CV19CO/open_controller_for_ventilator/README.md

# Open source controller board for ventilators 

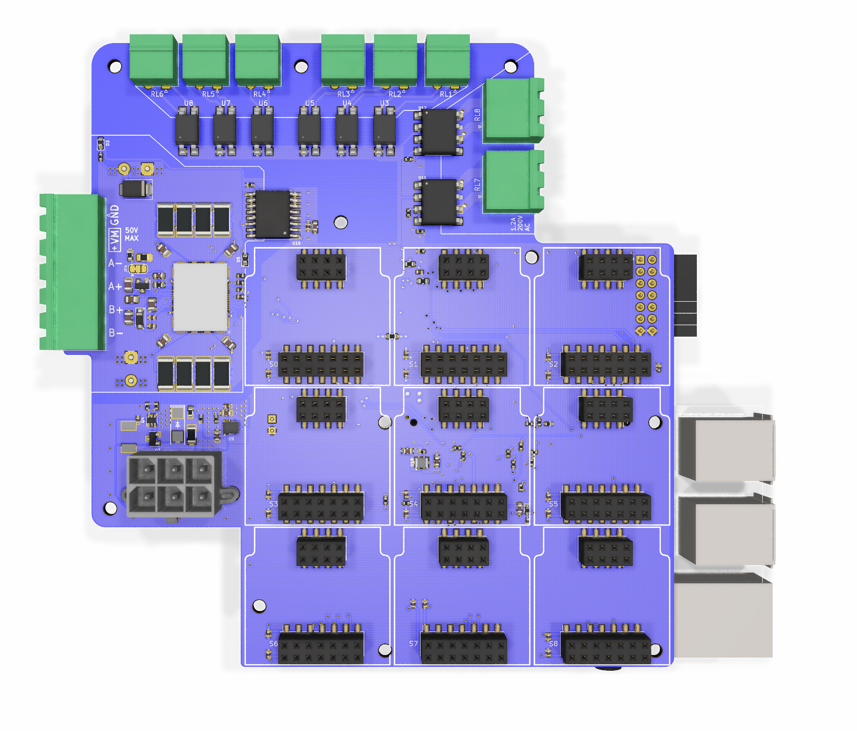
[picture p1: doc/top.png]
Top view


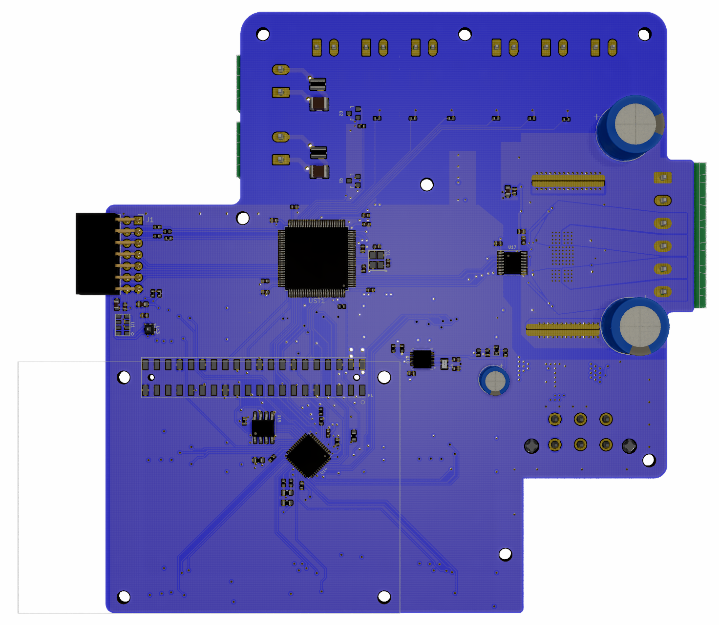
[picture p2: doc/bot.png]
Bottom view
