CV19CO/open_controller_for_ventilator/stm32f4_modules/readme.txt

Toolchain for stm32f4 programming:

> sudo apt-get install build-essential 
> sudo apt-get install git binutils-arm-none-eabi
> sudo apt-get install gcc-arm-none-eabi
> sudo apt-get install libnewlib-arm-none-eabi
