CV19CO/open_controller_for_ventilator/ABPDJJT001PGAA5_sensor/readme.txt

Sensor: ABPDANT015PGAA5 
Mouser: https://co.mouser.com/ProductDetail/785-ABPDANT015PGAA5
Datasheet: https://co.mouser.com/datasheet/2/187/honeywell-sensing-basic-board-mount-pressure-abp-s-1662208.pdf
