CV19CO/open_controller_for_ventilator/ABPDJJT001PDSA3_sensor/readme.txt

Sensor: ABPDJJT001PDSA3 
Mouser: https://co.mouser.com/ProductDetail/785-ABPDJJT001PDSA3
Datasheet: https://co.mouser.com/datasheet/2/187/honeywell-sensing-basic-board-mount-pressure-abp-s-1662208.pdf
