CV19CO/open_controller_for_ventilator/pressure_sensor_module/readme.txt

Sensor: MPX5100AP 
Mouser: https://co.mouser.com/ProductDetail/841-MPX5100AP
Datasheet: https://co.mouser.com/datasheet/2/302/MPX5100-1127023.pdf
