CV19CO/open_controller_for_ventilator/stm32f4_modules/modules/clk_ice40/leeme.txt

20200407
En esta versión se modificó la forma de enviar los datos 
colocando una única cadena con la información de los 16 canales
