CV19CO/open_controller_for_ventilator/sensor_oxigeno/BOM_sensor_oxigeno.csv

Item | Qty | Reference(s) | Value | Footprint
1 | 1 | J1 | Conn_01x02_Female | Connector:FanPinHeader_1x03_P2.54mm_Vertical
2 | 1 | J2 | Conn_02x07_Odd_Even | Connector_PinHeader_2.54mm:PinHeader_2x07_P2.54mm_Vertical
3 | 1 | J3 | Conn_02x04_Odd_Even | Connector_PinHeader_2.54mm:PinHeader_2x04_P2.54mm_Vertical
4 | 1 | R1 | 25.3 k | Resistor_THT:R_Axial_DIN0207_L6.3mm_D2.5mm_P7.62mm_Horizontal
5 | 1 | R2 | 100 | Resistor_THT:R_Axial_DIN0207_L6.3mm_D2.5mm_P7.62mm_Horizontal
6 | 4 | R3, R4, R5, R6 | 10k | Resistor_THT:R_Axial_DIN0207_L6.3mm_D2.5mm_P7.62mm_Horizontal
7 | 1 | R7 | 50 | Resistor_THT:R_Axial_DIN0207_L6.3mm_D2.5mm_P7.62mm_Horizontal
8 | 1 | U1 | LM318N | Package_DIP:DIP-8_W7.62mm
9 | 1 | U2 | INA128 | Package_DIP:DIP-8_W7.62mm
