CV19CO/open_controller_for_ventilator/ABPDJJT001PDSA3_sensor/BOM_ABPDJJT001PDSA3_sensor_module.csv

Reference | Quantity | Value | Footprint | Datasheet | DigiKey
C1 | 1 | 0.1u | Capacitor_SMD:C_0603_1608Metric | ~ | 1276-1258-1-ND
J1 | 1 | Conn_02x04_Odd_Even | Connector_PinHeader_2.54mm:PinHeader_2x04_P2.54mm_Vertical_SMD | ~ | 609-6367-ND
J2 | 1 | Conn_02x07_Odd_Even | Connector_PinHeader_2.54mm:PinHeader_2x07_P2.54mm_Vertical_SMD | ~ | 609-6365-ND
U1 | 1 | ABPDJJ001PDSA3 | TH_project:DIP_JJ
