CV19CO/open_controller_for_ventilator/pressure_sensor_module/BOM_pressure_sensor_module.csv

Reference | Quantity | Value | Footprint | Datasheet | DigiKey
C1 | 1 | 1u | Capacitor_SMD:C_0603_1608Metric | ~ | 1276-1182-1-ND
C2 | 1 | 470p | Capacitor_SMD:C_0603_1608Metric | ~ | 1276-1168-1-ND
C3 C4 | 2 | 0.1u | Capacitor_SMD:C_0603_1608Metric | ~ | 1276-1258-1-ND
J1 | 1 | Conn_02x04_Odd_Even | Connector_PinHeader_2.54mm:PinHeader_2x04_P2.54mm_Vertical_SMD | ~ | 609-6367-ND
J2 | 1 | Conn_02x07_Odd_Even | Connector_PinHeader_2.54mm:PinHeader_2x07_P2.54mm_Vertical_SMD | ~ | 609-6365-ND
R1 | 1 | 11k3 | Resistor_SMD:R_0603_1608Metric | ~ | A102208CT-ND
R2 | 1 | 22k | Resistor_SMD:R_0603_1608Metric | ~ | A103066CT-ND
U1 | 1 | MPX5100AP | TH_project:MPX5100
U2 | 1 | LM358 | Package_SO:TSSOP-8_4.4x3mm_P0.65mm | http://www.ti.com/lit/ds/symlink/lm2904-n.pdf | 296-51268-1-ND
