CV19CO/open_controller_for_ventilator/kicad-modules/shapes3d/User Library-bornera-1.STEP

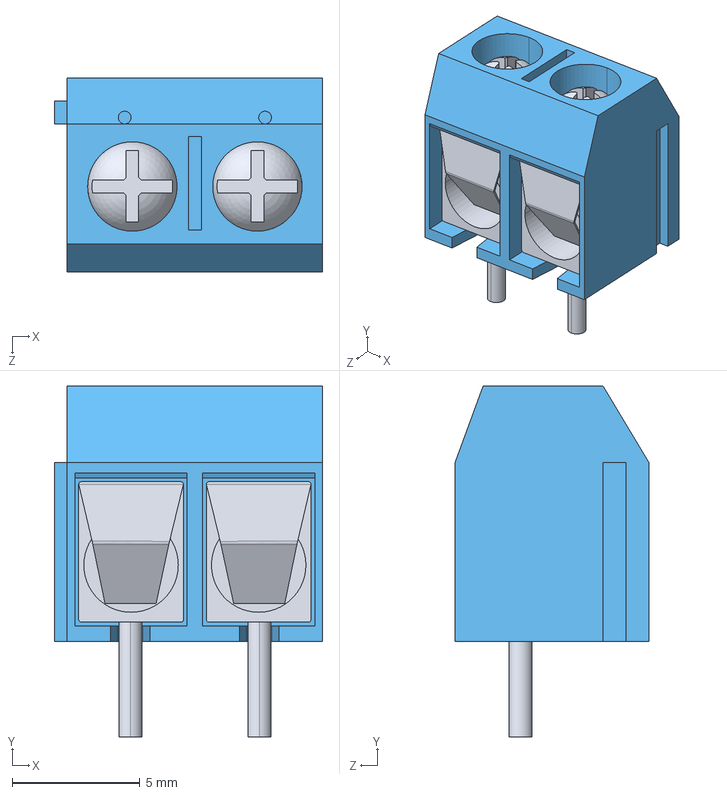
[picture p3: CAD file, 2023-04-05]
kicad-modules/shapes3d/User Library-bornera-1.STEP
10.5 x 13.8 x 7.60 mm
