CV19CO/open_controller_for_ventilator/pressure_sensor_module/pressure_sensor_module.step

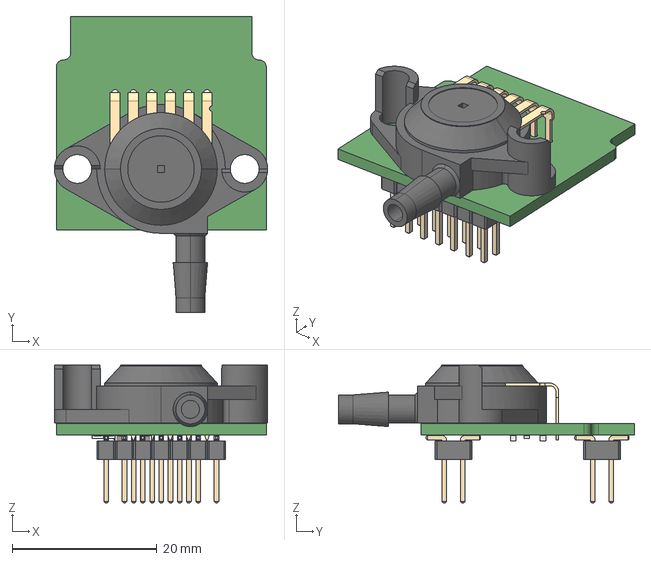
[picture p4: CAD file, 2020-06-25]
pressure_sensor_module/pressure_sensor_module.step
29.5 x 40.9 x 19.0 mm
