CV19CO/open_controller_for_ventilator/kicad-modules/shapes3d/abpdjjt001pgaa5.stp

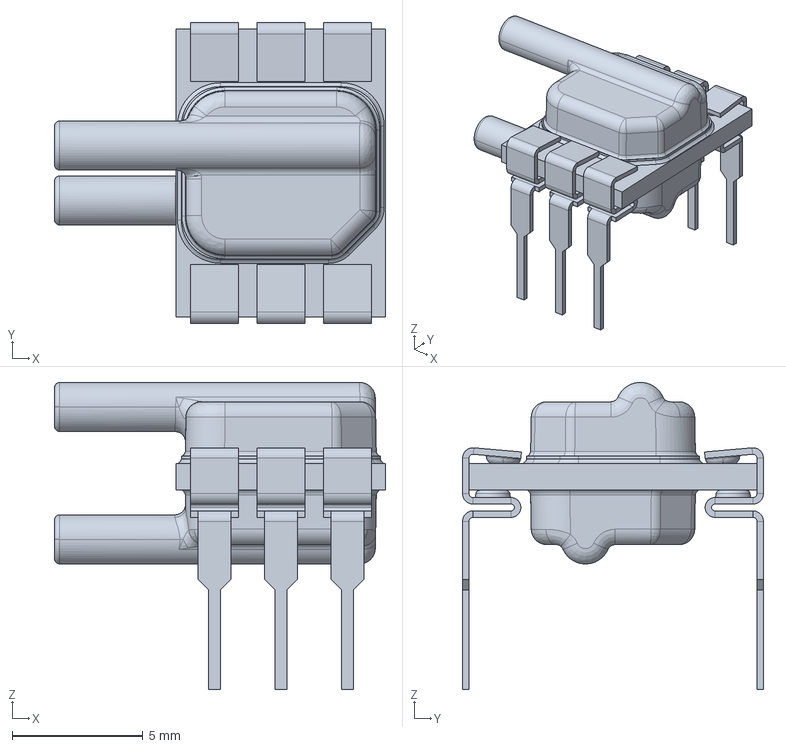
[picture p5: CAD file, 2022-02-02]
kicad-modules/shapes3d/abpdjjt001pgaa5.stp
12.7 x 11.5 x 11.7 mm
