CV19CO/open_controller_for_ventilator/kicad-modules/shapes3d/abpdant005pgaa5.stp

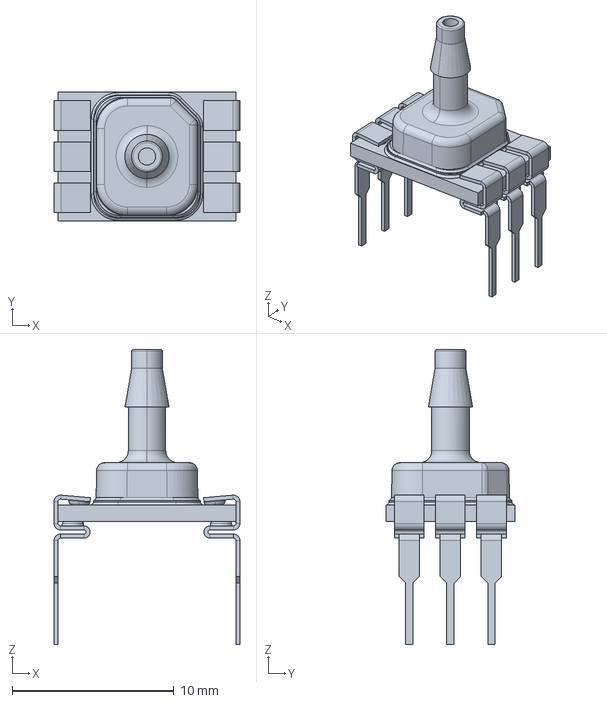
[picture p6: CAD file, 2022-02-02]
kicad-modules/shapes3d/abpdant005pgaa5.stp
11.5 x 8.00 x 18.2 mm
