CV19CO/open_controller_for_ventilator/kicad-modules/shapes3d/ABPDJJT001PDSA3.stp

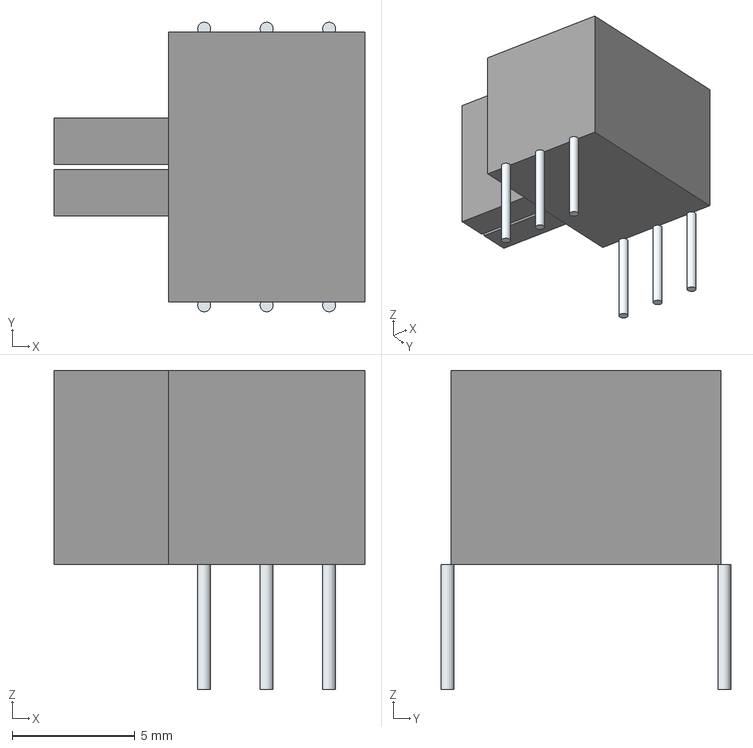
[picture p7: CAD file, 2020-07-11]
kicad-modules/shapes3d/ABPDJJT001PDSA3.stp
12.6 x 11.8 x 13.0 mm
Leads
