CV19CO/open_controller_for_ventilator/kicad-modules/shapes3d/MPX5100GP.step

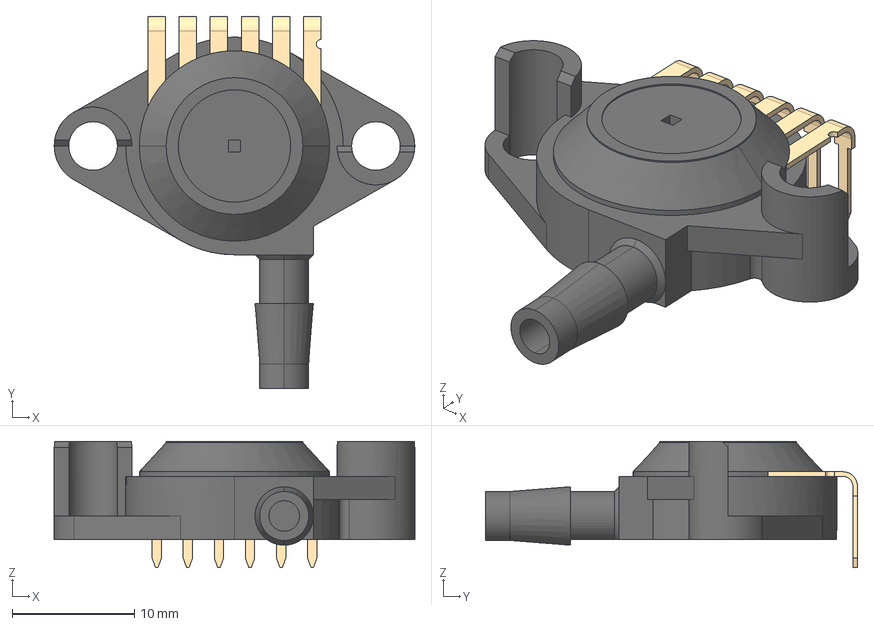
[picture p8: CAD file, 2020-06-25]
kicad-modules/shapes3d/MPX5100GP.step
29.5 x 30.4 x 10.3 mm
