CV19CO/open_controller_for_ventilator/kicad-modules/shapes3d/S-Mini-ZKN.STEP

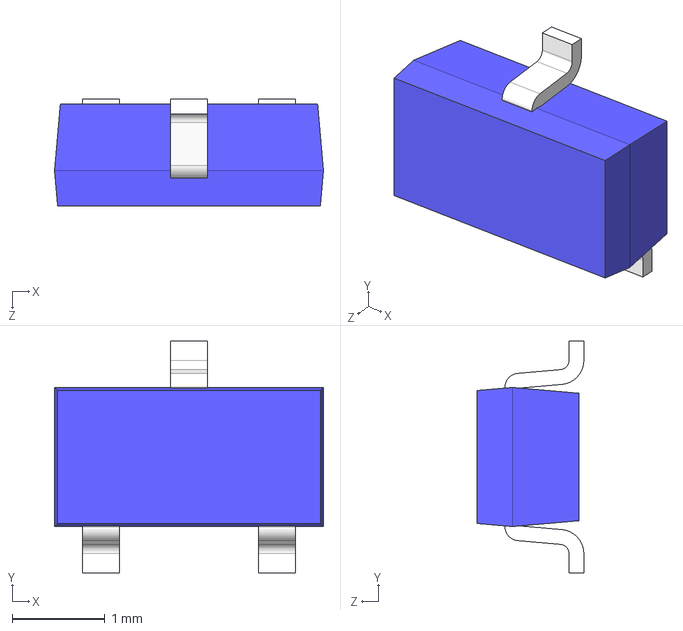
[picture p9: CAD file, 2020-05-23]
kicad-modules/shapes3d/S-Mini-ZKN.STEP
2.90 x 2.50 x 1.15 mm
