CV19CO/open_controller_for_ventilator/kicad-modules/shapes3d/CUI_DEVICES_CSS-95B30-SMT-TR.step

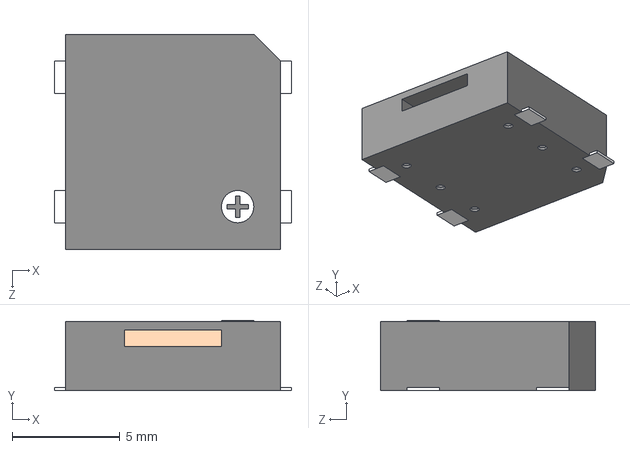
[picture p10: CAD file, 2020-05-11]
kicad-modules/shapes3d/CUI_DEVICES_CSS-95B30-SMT-TR.step
11.0 x 3.25 x 10.0 mm
