CV19CO/open_controller_for_ventilator/kicad-modules/shapes3d/pxc_1757284_06_MSTBA-2-5-6-G-5-08_3D.stp

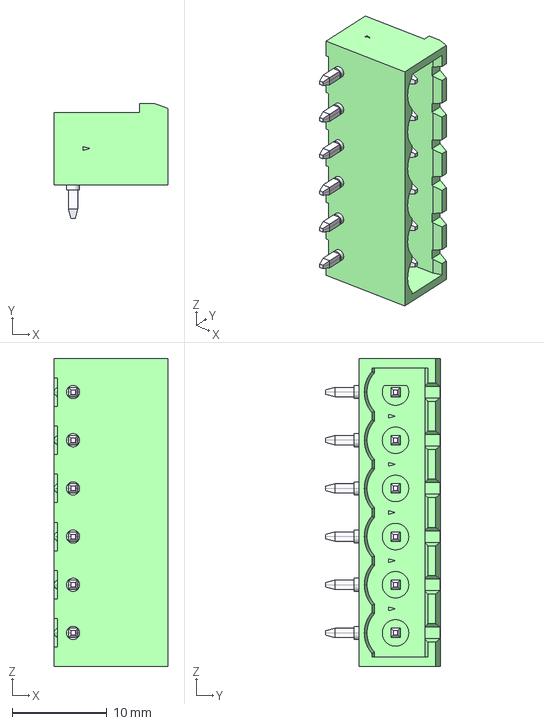
[picture p11: CAD file, 2020-05-11]
kicad-modules/shapes3d/pxc_1757284_06_MSTBA-2-5-6-G-5-08_3D.stp
12.0 x 12.1 x 32.5 mm
