CV19CO/open_controller_for_ventilator/kicad-modules/shapes3d/CUI_DEVICES_CEP-1112.step

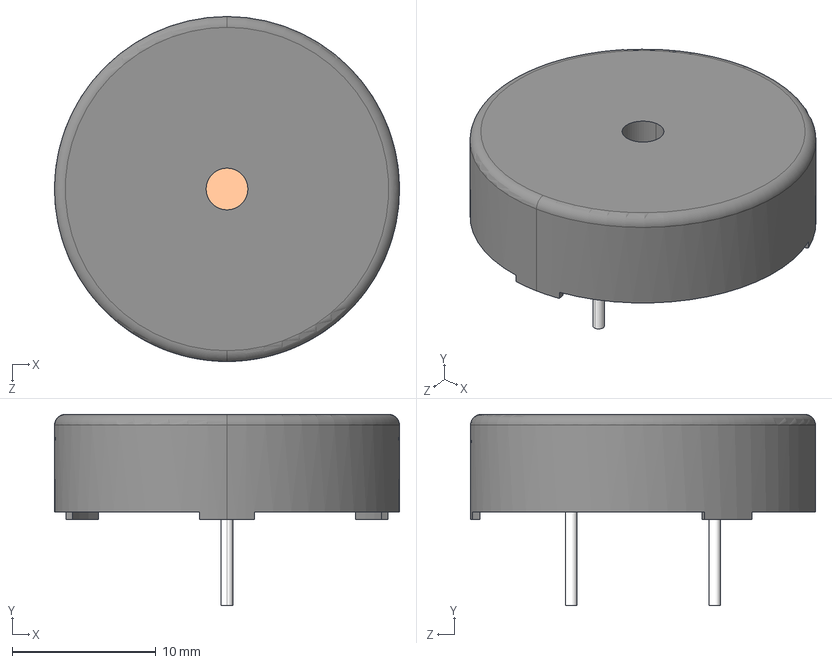
[picture p12: CAD file, 2020-05-11]
kicad-modules/shapes3d/CUI_DEVICES_CEP-1112.step
24.0 x 13.3 x 24.0 mm
