CV19CO/open_controller_for_ventilator/kicad-modules/shapes3d/HTS221TR.STEP

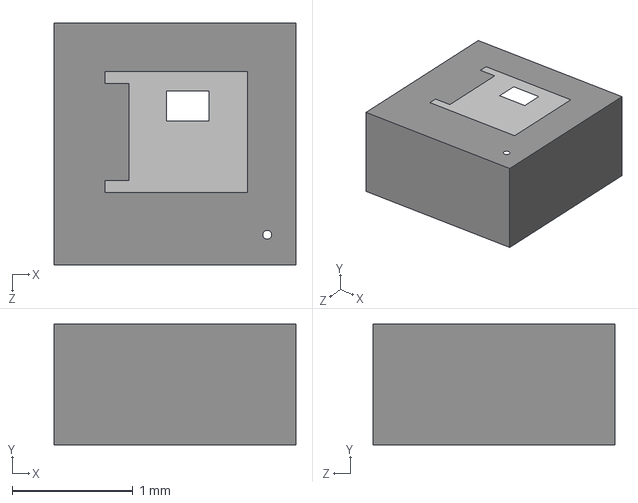
[picture p13: CAD file, 2020-04-28]
kicad-modules/shapes3d/HTS221TR.STEP
2.00 x 1.00 x 2.00 mm
