CV19CO/open_controller_for_ventilator/kicad-modules/shapes3d/XCL220B153FR.step

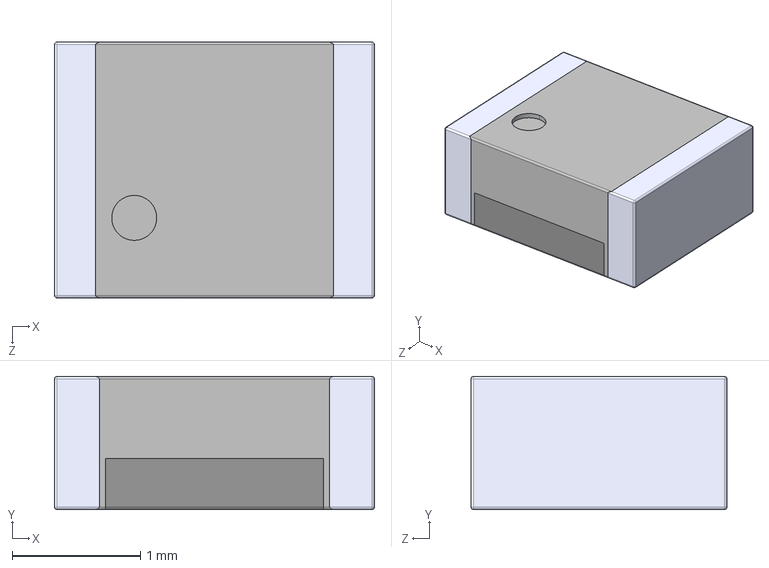
[picture p14: CAD file, 2020-04-28]
kicad-modules/shapes3d/XCL220B153FR.step
2.50 x 1.04 x 2.00 mm
