CV19CO/open_controller_for_ventilator/kicad-modules/shapes3d/XCL214B123DR.step

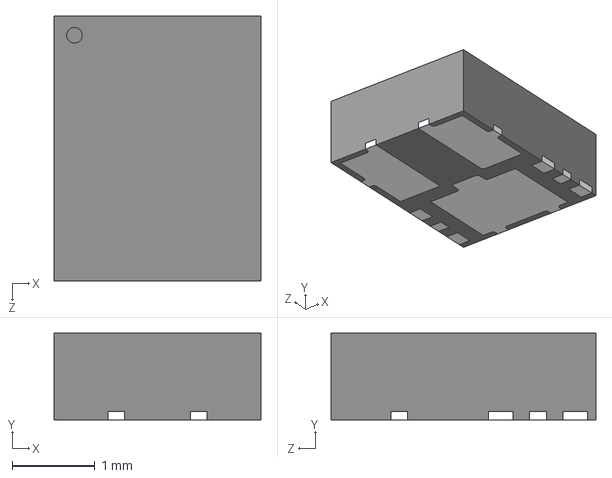
[picture p15: CAD file, 2020-04-28]
kicad-modules/shapes3d/XCL214B123DR.step
2.50 x 1.05 x 3.20 mm
