CV19CO/open_controller_for_ventilator/kicad-modules/shapes3d/ABS06-107.STEP

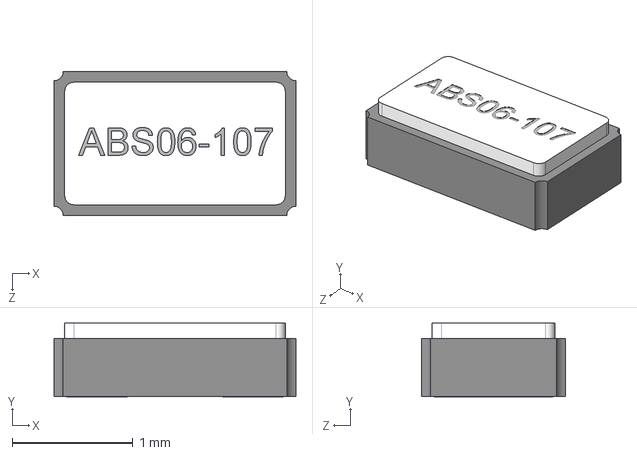
[picture p16: CAD file, 2020-04-21]
kicad-modules/shapes3d/ABS06-107.STEP
2.01 x 0.612 x 1.19 mm
