CV19CO/open_controller_for_ventilator/kicad-modules/shapes3d/CUI_PJ-002A.step

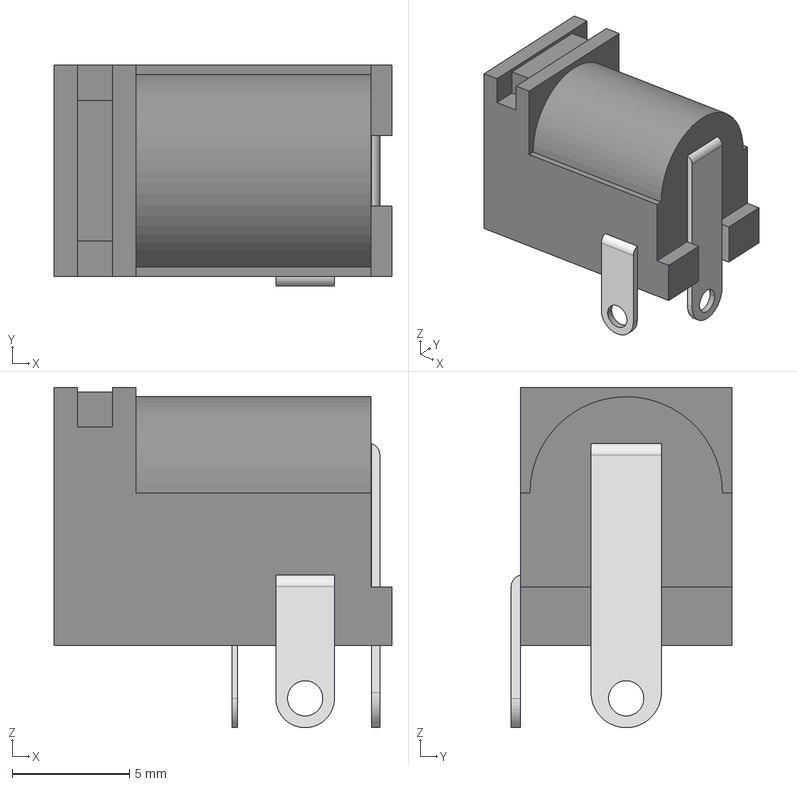
[picture p17: CAD file, 2020-04-12]
kicad-modules/shapes3d/CUI_PJ-002A.step
14.4 x 9.40 x 14.5 mm
