CV19CO/open_controller_for_ventilator/kicad-modules/shapes3d/SOT-223.step

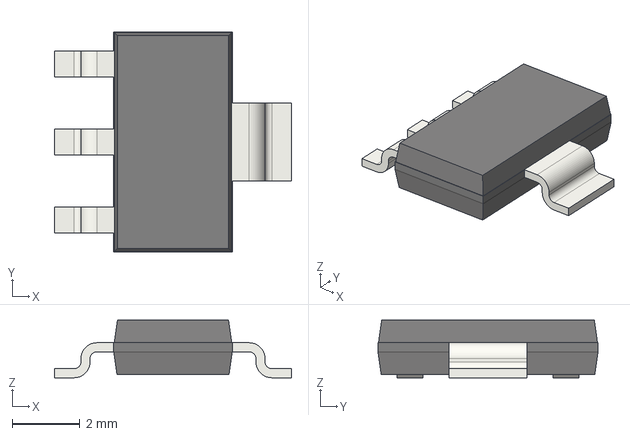
[picture p18: CAD file, 2020-04-12]
kicad-modules/shapes3d/SOT-223.step
7.00 x 6.50 x 1.70 mm
