CV19CO/open_controller_for_ventilator/kicad-modules/shapes3d/HVSON8.step

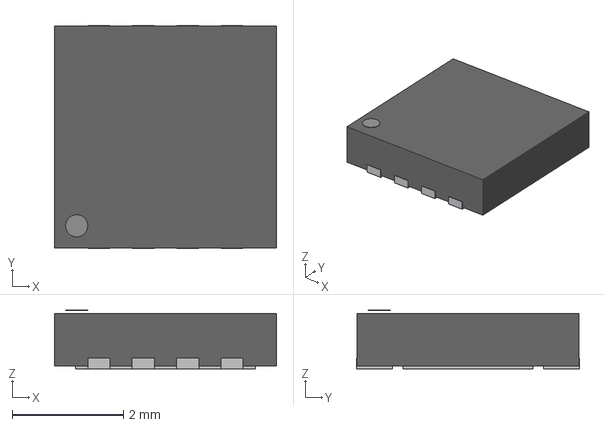
[picture p19: CAD file, 2020-04-09]
kicad-modules/shapes3d/HVSON8.step
4.00 x 4.02 x 1.06 mm
