CV19CO/open_controller_for_ventilator/kicad-modules/shapes3d/raspberryPi3BSimplified_STEP.STEP

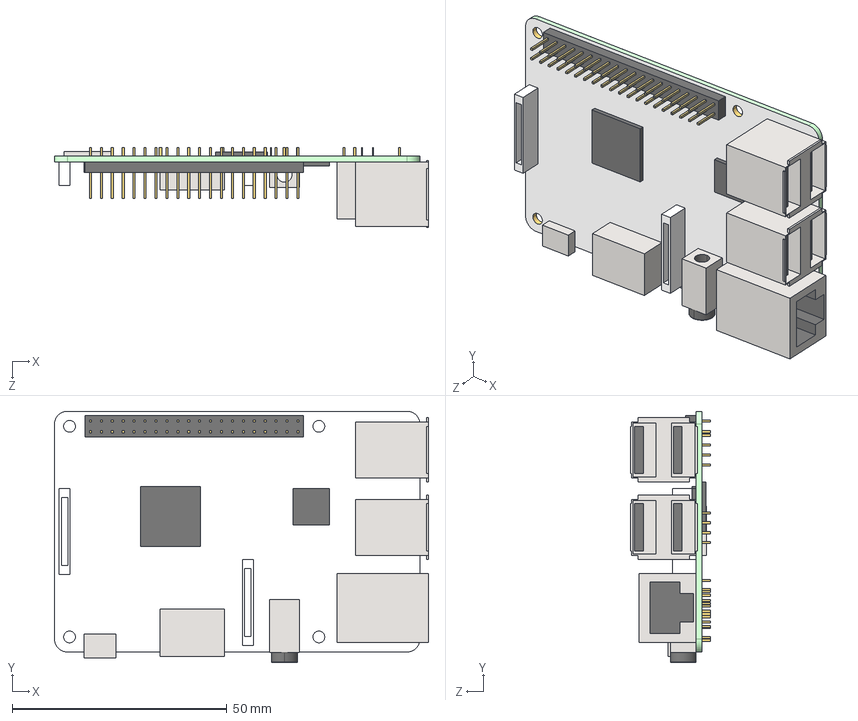
[picture p20: CAD file, 2020-04-08]
kicad-modules/shapes3d/raspberryPi3BSimplified_STEP.STEP
87.0 x 58.5 x 18.6 mm
