CV19CO/open_controller_for_ventilator/kicad-modules/shapes3d/PAN_AQY21-SO4-L.step

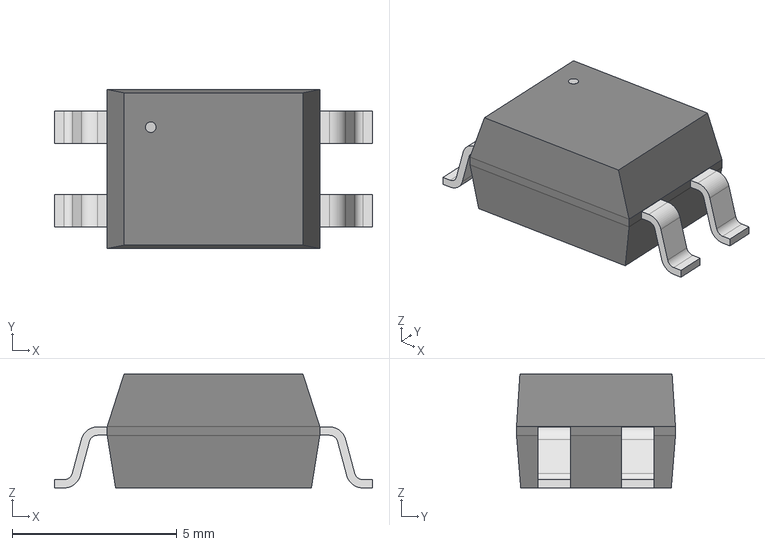
[picture p21: CAD file, 2020-04-08]
kicad-modules/shapes3d/PAN_AQY21-SO4-L.step
9.65 x 4.83 x 3.46 mm
