CV19CO/open_controller_for_ventilator/kicad-modules/shapes3d/TLP240D_TP1.step

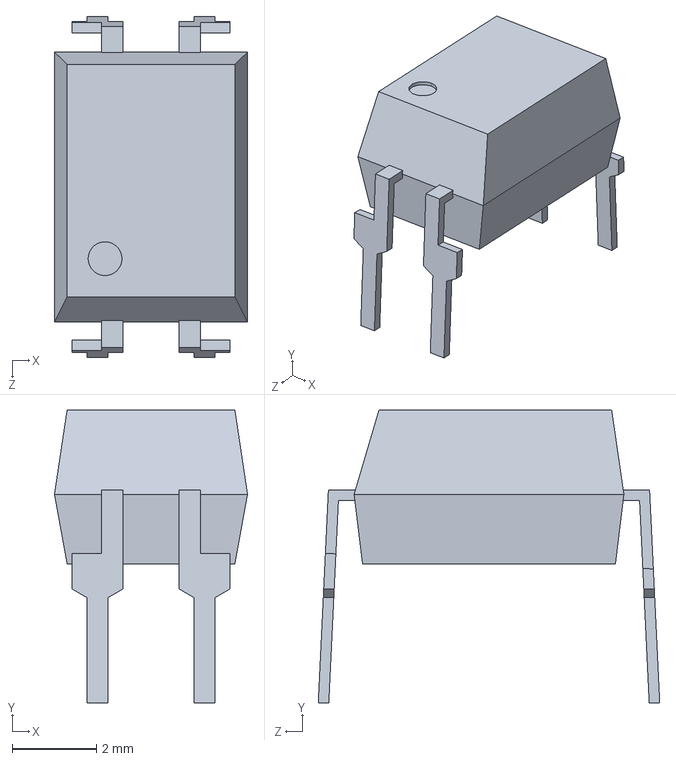
[picture p22: CAD file, 2020-04-08]
kicad-modules/shapes3d/TLP240D_TP1.step
4.58 x 6.95 x 8.10 mm
