CV19CO/open_controller_for_ventilator/kicad-modules/shapes3d/VFQFPN_11x14x1mm.scad

color ("black") {
    translate([-11/2,-14/2,0]) {        
        cube( [11,14,1] );
    }
}
