CV19CO/open_controller_for_ventilator/kicad-modules/shapes3d/XDFN4_1x1mm.scad

color ("black") {
    translate([-0.5,-0.5,0]) {        
        cube( [1,1,0.4] );
    }
}
