CV19CO/open_controller_for_ventilator/(list of files, cad)

Other CAD files:
kicad-modules/shapes3d/PAN_AQY21-SO4.step
kicad-modules/shapes3d/PAN_AQY21-SO4-M.step
kicad-modules/5600200430/5600200430.step
kicad-modules/shapes3d/10142708-04xxxlf.stp
kicad-modules/shapes3d/10142708-06xxxlf.stp
kicad-modules/shapes3d/10142708-08xxxlf.stp
kicad-modules/shapes3d/5024430270.stp
kicad-modules/shapes3d/5024430470.stp
kicad-modules/shapes3d/5600200430.step
