CV19CO/open_controller_for_ventilator/keep_breathing_ctrl.pdf

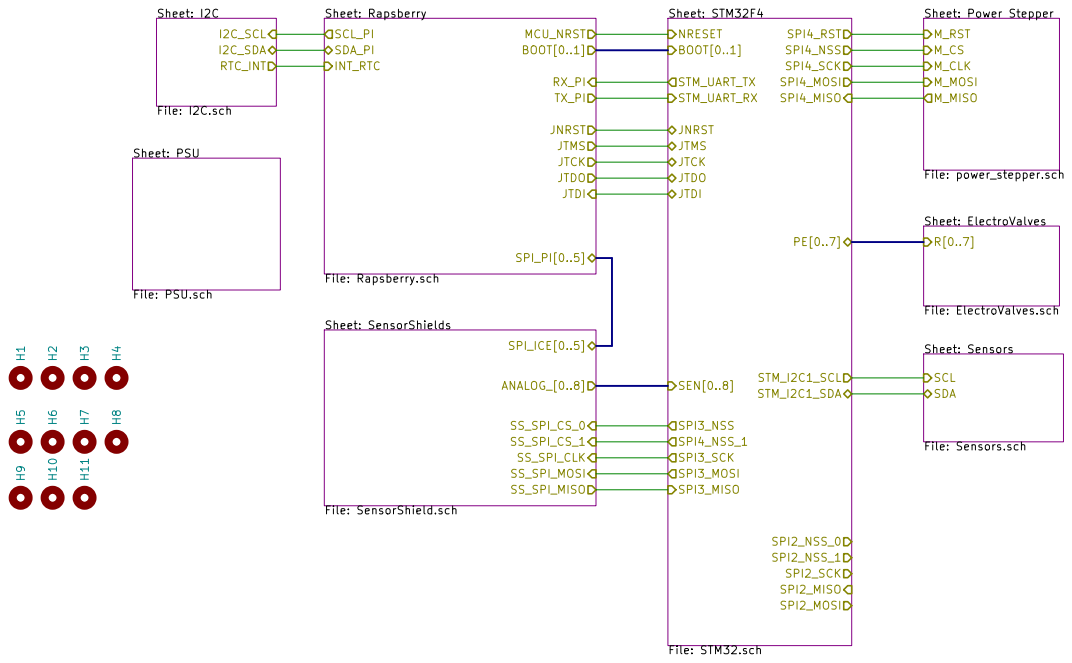
[picture p23: page 1]

Sheet: ElectroValves File: ElectroValves.sch R[0..7] Sheet: I2C

SPI2_NSS_1 SPI2_NSS_0 SPI4_RST STM_I2C1_SCL NRESET BOOT[0..1] SPI4_NSS_1 Sheet: Rapsberry

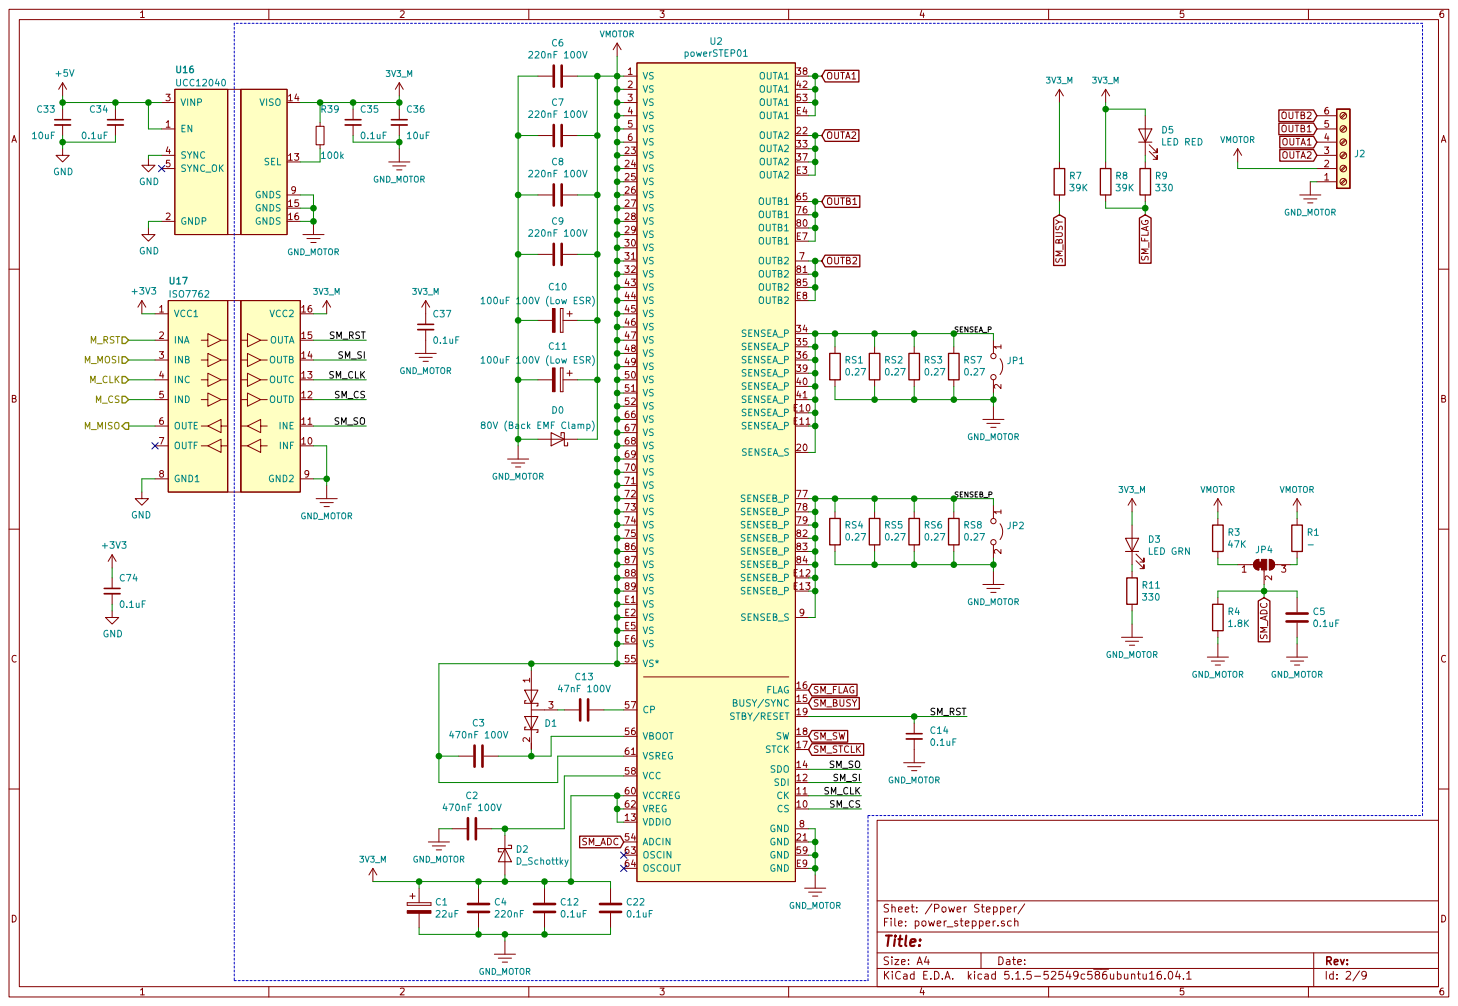
[picture p24: page 2]

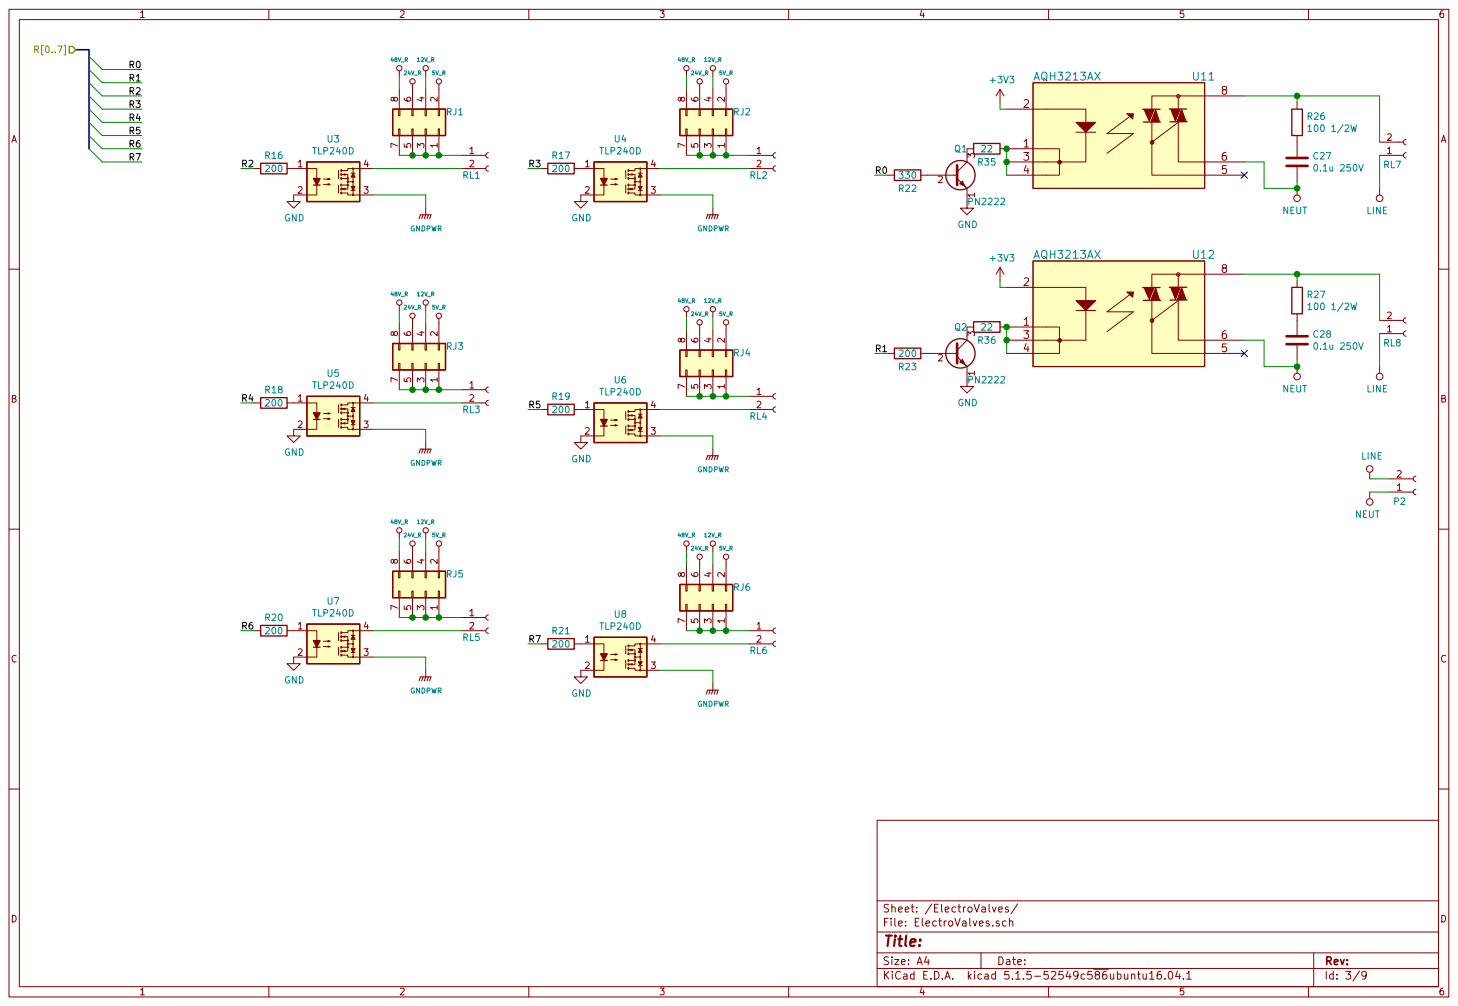
[picture p25: page 3]

Id: 3/9 Title: File: ElectroValves.sch Sheet: /ElectroValves/

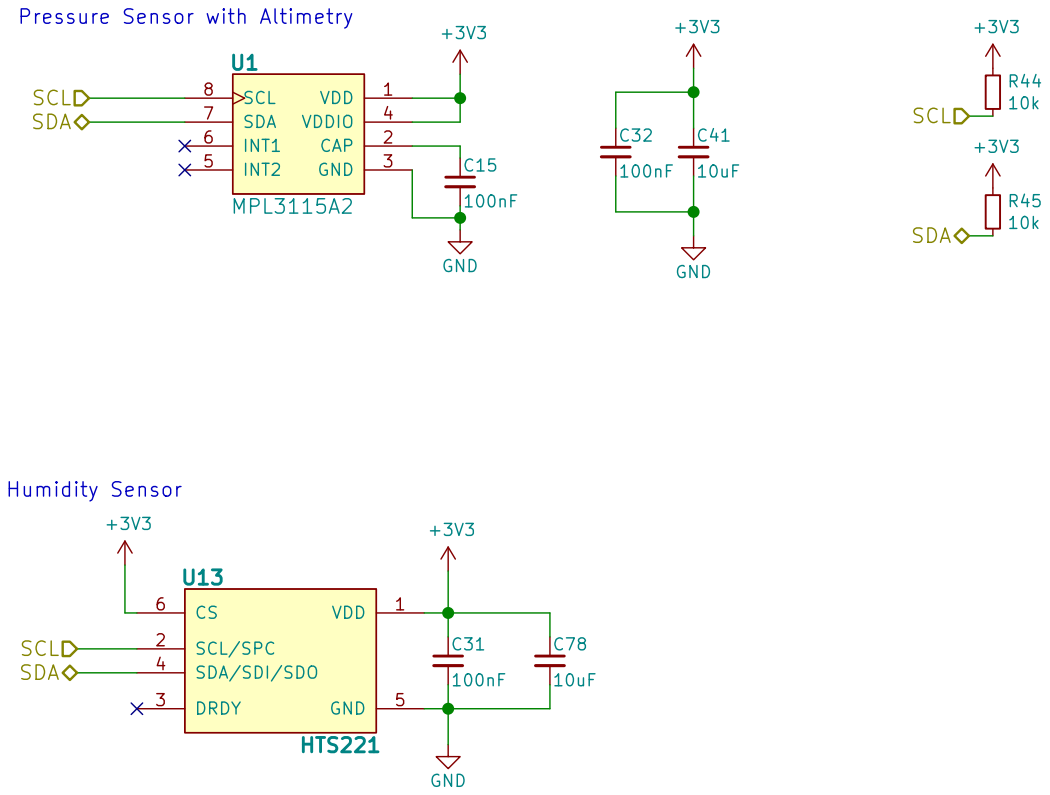
[picture p26: page 4]

Pressure Sensor with Altimetry

File: Sensors.sch Sheet: /Sensors/ UN

Id: 4/9 Title: Open Controller V1.0

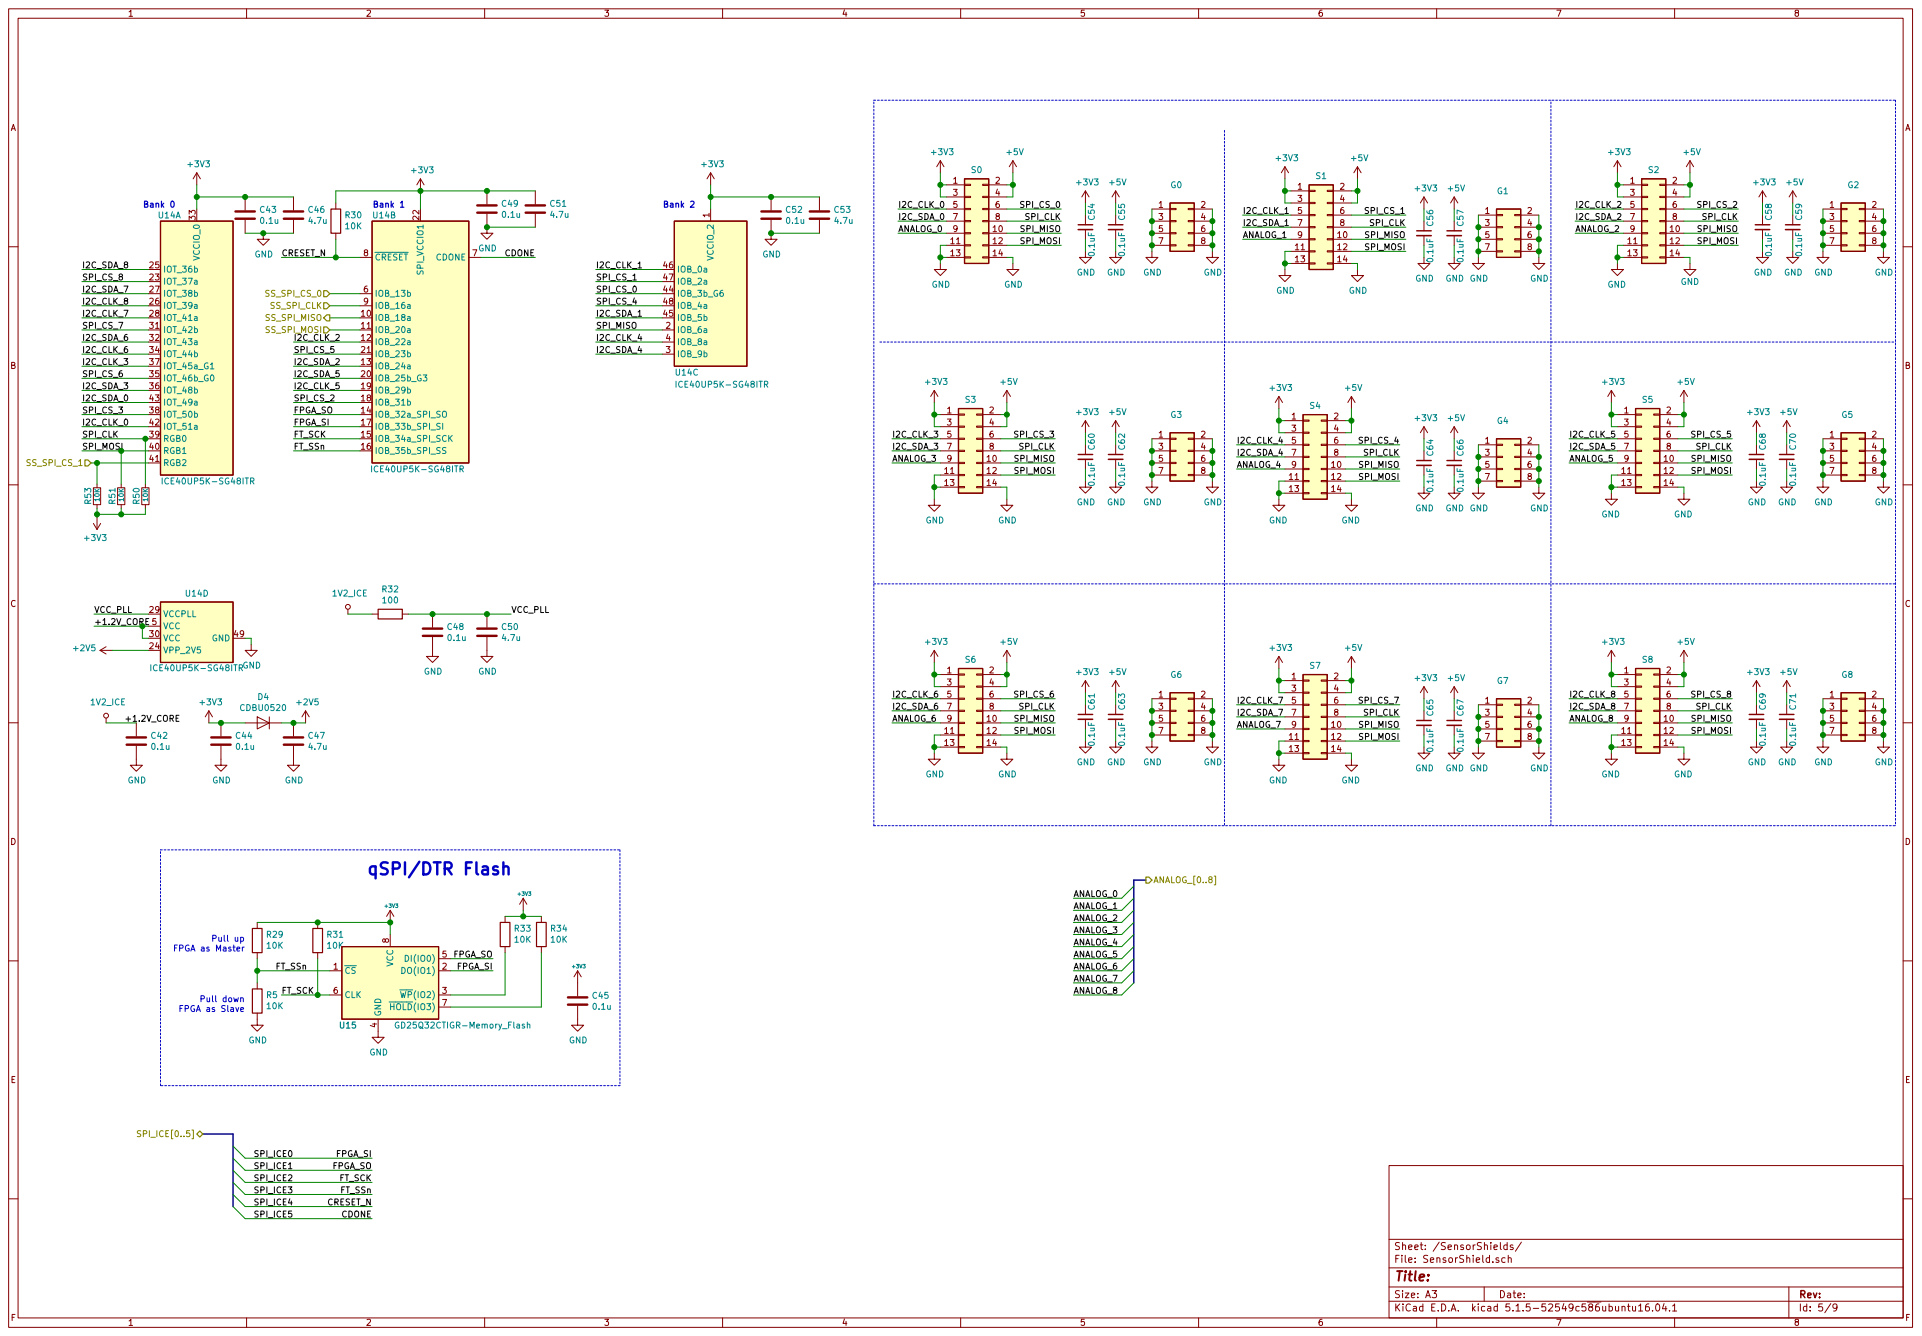
[picture p27: page 5]

Pull up FPGA as Master Pull down FPGA as Slave

4 DI(IO0) 5 CLK 6 HOLD(IO3) 7 VCC

Id: 5/9 Title: File: SensorShield.sch Sheet: /SensorShields/

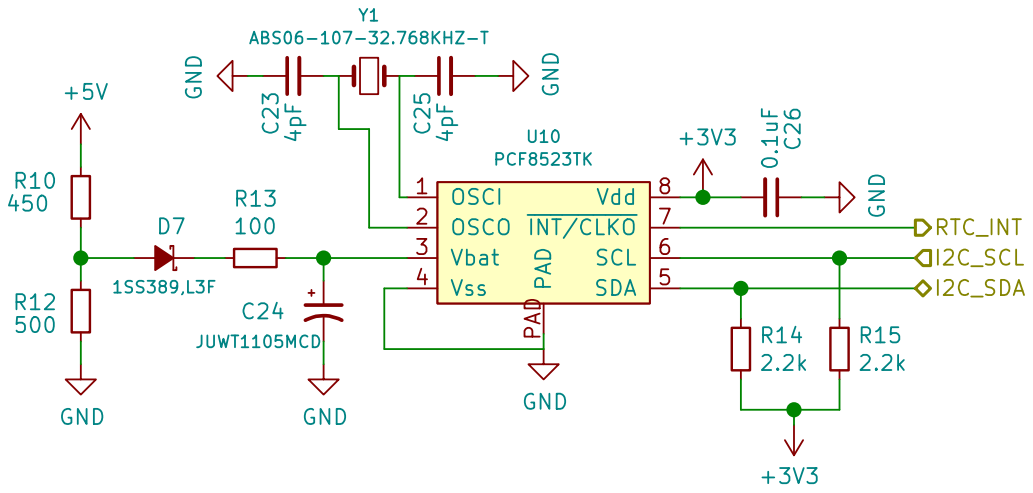
[picture p28: page 6]

Id: 6/9 Title: File: I2C.sch Sheet: /I2C/

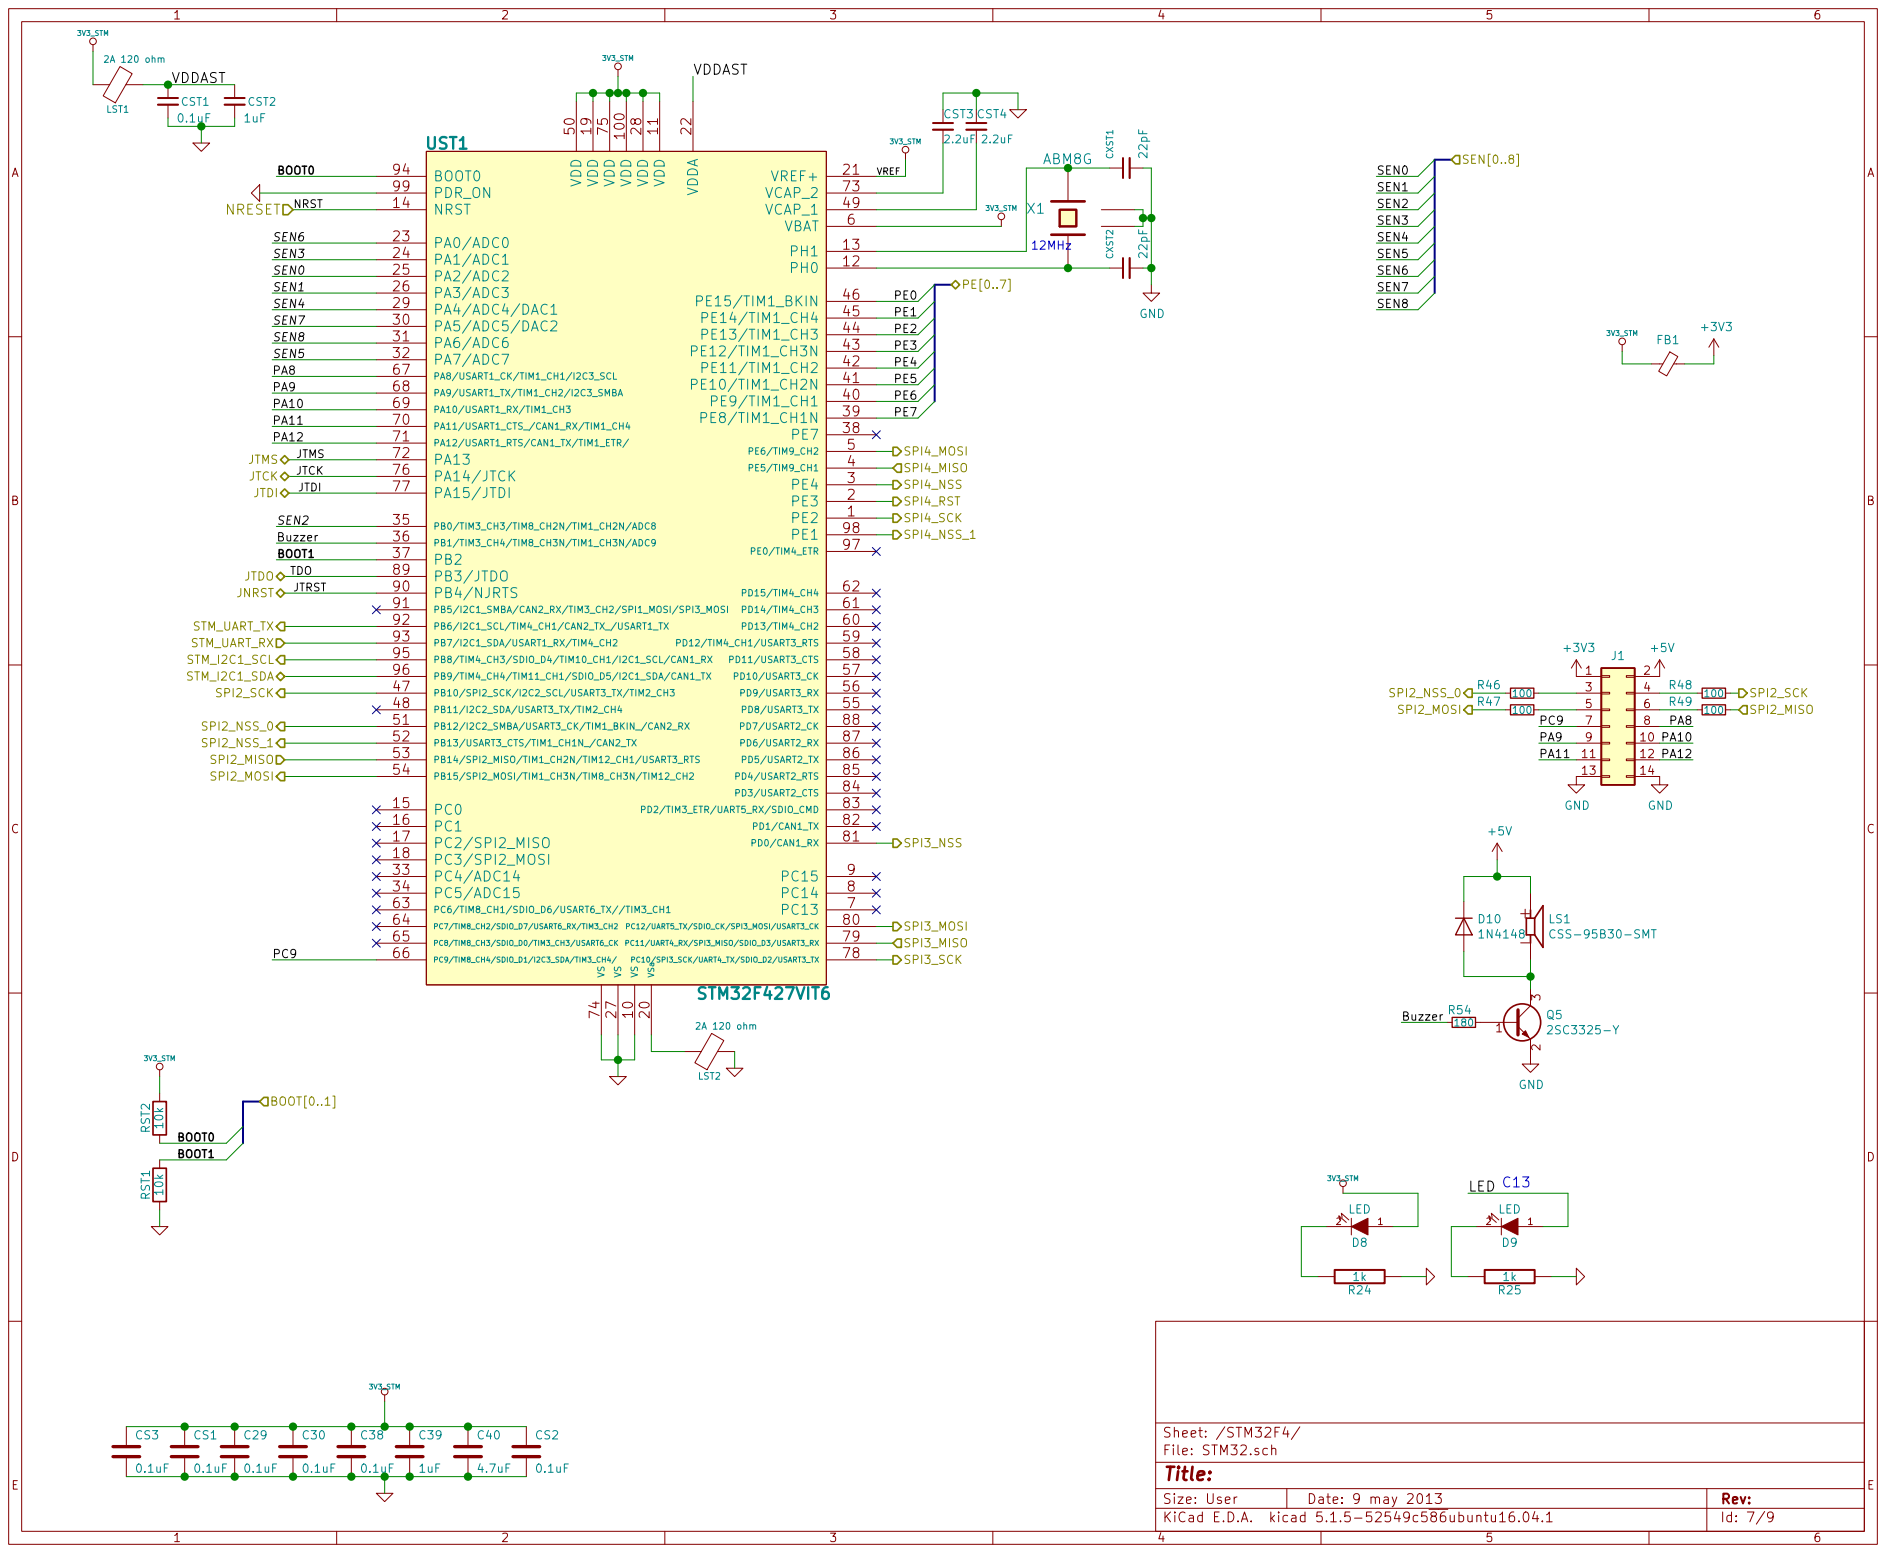
[picture p29: page 7]

Id: 7/9 Title: File: STM32.sch Sheet: /STM32F4/

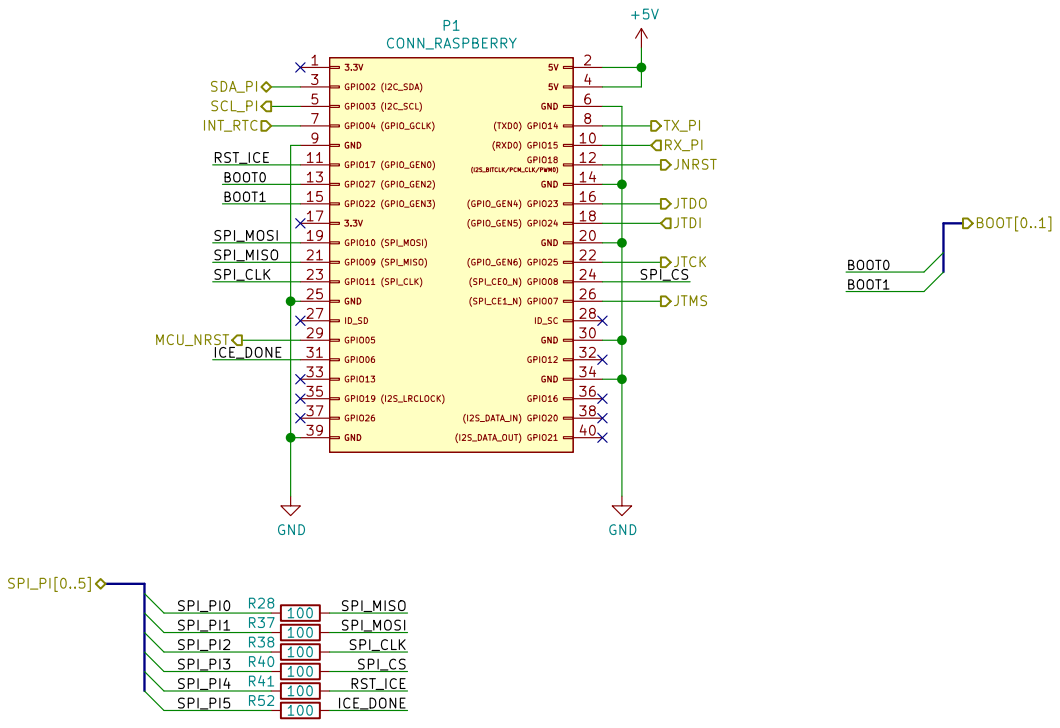
[picture p30: page 8]

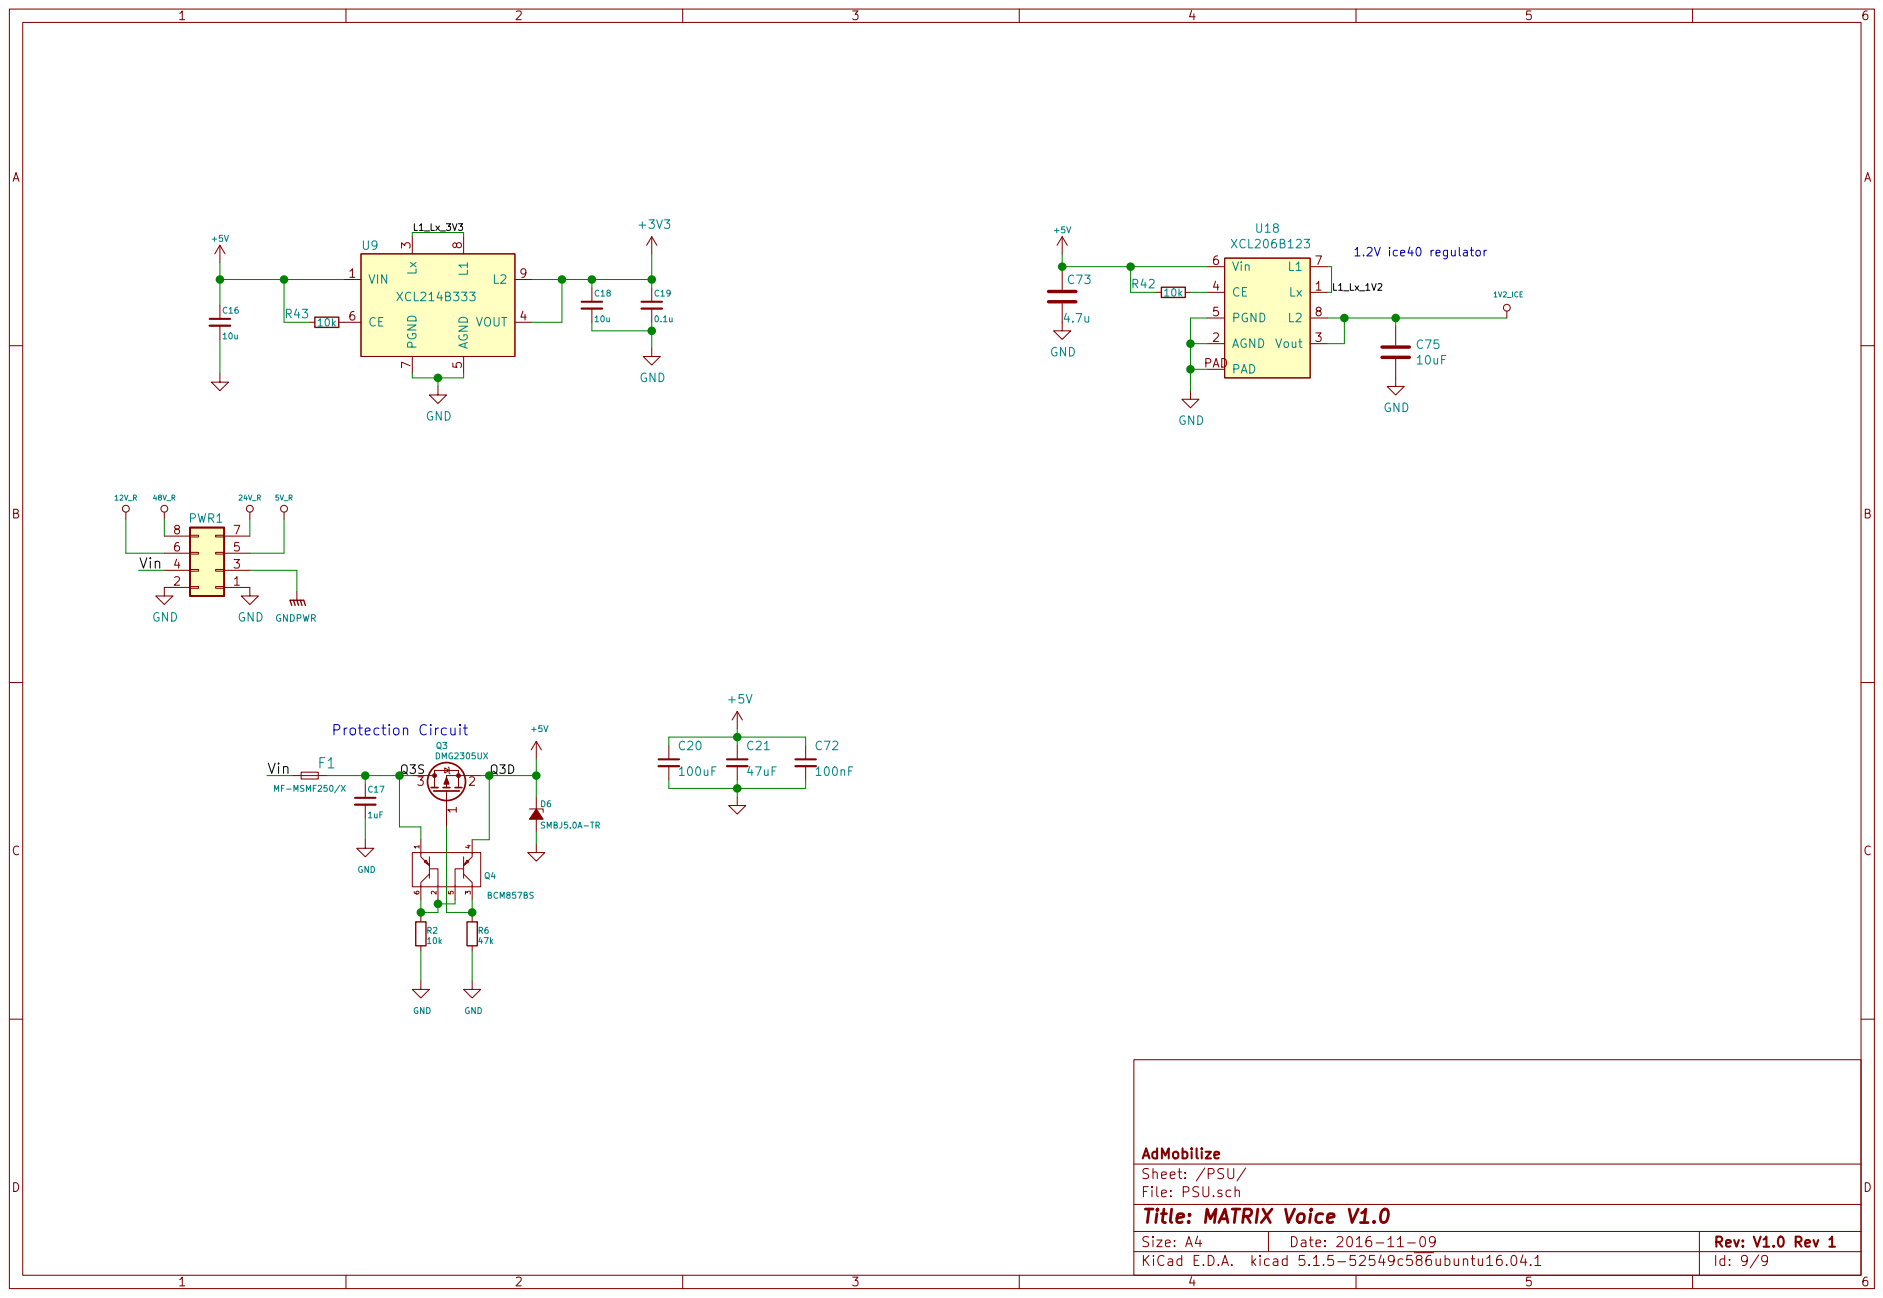
[picture p31: page 9]

10k | XCL206B123 GND

File: PSU.sch Sheet: /PSU/ AdMobilize C72

Id: 9/9 Title: MATRIX Voice V1.0
