CV19CO/open_controller_for_ventilator/electrovalve_module/electrovalves_module.kicad_pcb

## KiCad design electrovalve_module/electrovalves_module.kicad_pcb (2023-04-05)

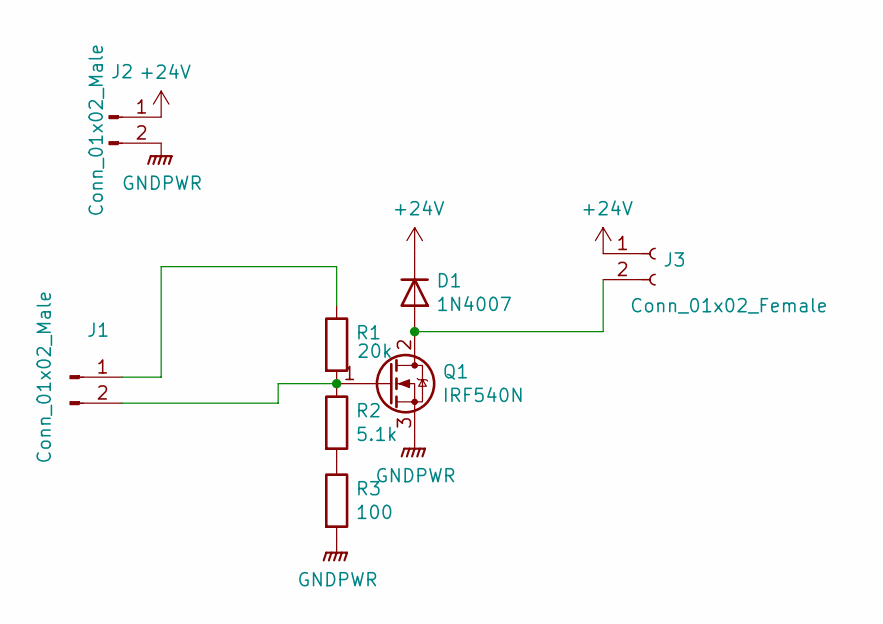
[picture p41: schematic electrovalves_module.sch]

Parts:
D1: 1N4007; D_DO-41_SOD81_P10.16mm_Horizontal
J1, J2: Conn_01x02_Male; TerminalBlock_bornier-2_P5.08mm
J3: Conn_01x02_Female; TerminalBlock_bornier-2_P5.08mm
Q1: IRF540N; TO-220-3_Vertical
R1: 20k; R_Axial_DIN0207_L6.3mm_D2.5mm_P7.62mm_Horizontal
R2: 5.1k; R_Axial_DIN0207_L6.3mm_D2.5mm_P7.62mm_Horizontal
R3: 100; R_Axial_DIN0207_L6.3mm_D2.5mm_P7.62mm_Horizontal

Connections:
+24V: D1.1 (K), J2.1, J3.1
GNDPWR: J2.2, Q1.3 (S), R3.2
unnamed: D1.2 (A), J3.2, Q1.2 (D)
unnamed: J1.1, R1.1
unnamed: J1.2, Q1.1 (G), R1.2, R2.1
unnamed: R2.2, R3.1

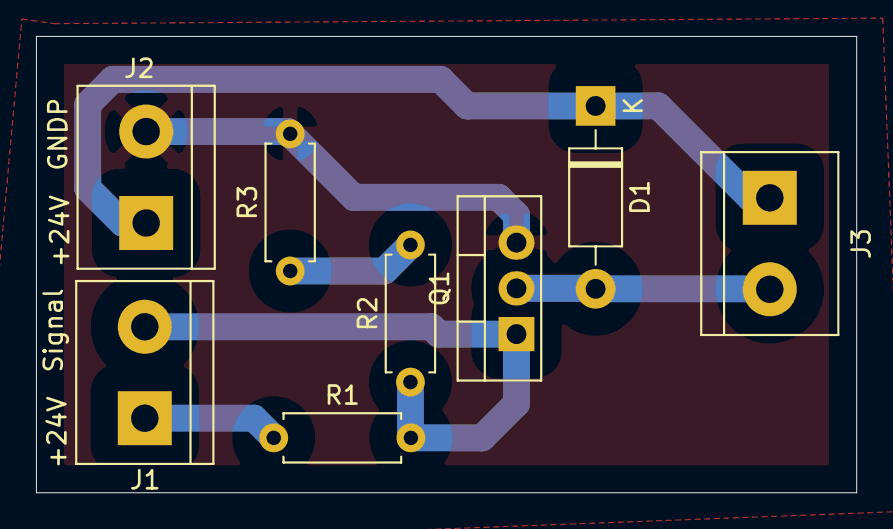
[picture p42: board electrovalves_module.kicad_pcb from above]

Board: 2 copper layers, 45.6 x 25.3 mm, 8 parts (0 on the bottom side), 6 nets.
