CV19CO/open_controller_for_ventilator/sensor_oxigeno/sensor_oxigeno.kicad_pcb

## KiCad design sensor_oxigeno/sensor_oxigeno.kicad_pcb (2022-05-27)

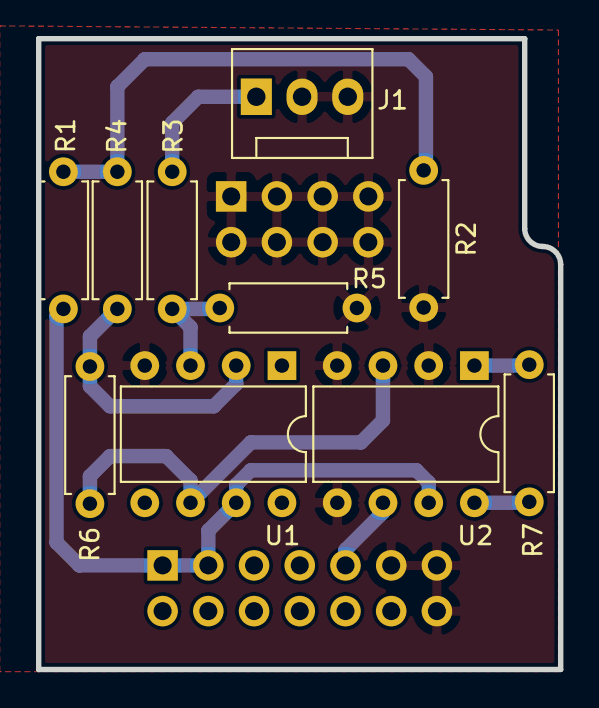
[picture p43: board sensor_oxigeno.kicad_pcb from above]

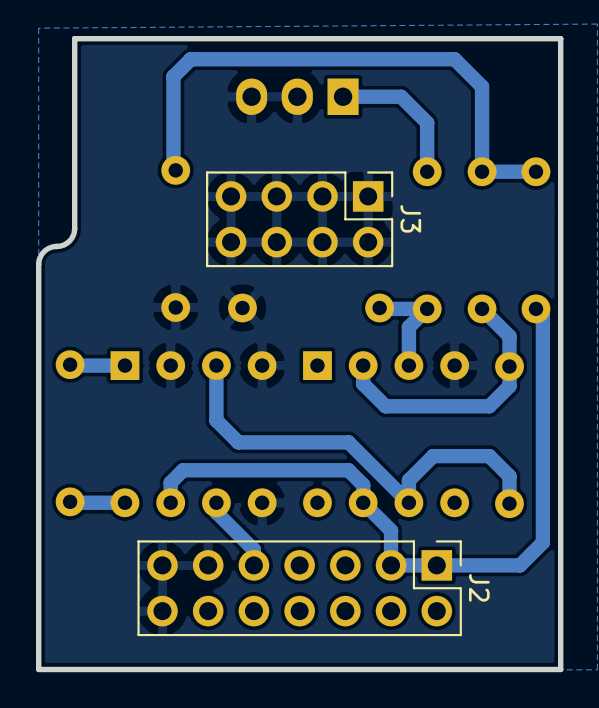
[picture p44: board sensor_oxigeno.kicad_pcb from below]

Board: 4 copper layers, 29.0 x 35.0 mm, 12 parts (2 on the bottom side), 10 nets.

Parts:
J1: Conn_01x02_Female; FanPinHeader_1x03_P2.54mm_Vertical
J2: Conn_02x07_Odd_Even; PinHeader_2x07_P2.54mm_Vertical
J3: Conn_02x04_Odd_Even; PinHeader_2x04_P2.54mm_Vertical
R1: 25.3 k; R_Axial_DIN0207_L6.3mm_D2.5mm_P7.62mm_Horizontal
R2: 100; R_Axial_DIN0207_L6.3mm_D2.5mm_P7.62mm_Horizontal
R3, R4, R5, R6: 10k; R_Axial_DIN0207_L6.3mm_D2.5mm_P7.62mm_Horizontal
R7: 50; R_Axial_DIN0207_L6.3mm_D2.5mm_P7.62mm_Horizontal
U1: LM318N; DIP-8_W7.62mm
U2: INA128; DIP-8_W7.62mm

Connections:
+3V3: J2.1, J2.3, R1.2, U1.7, U2.7
/Analog: J2.9, U2.6
GND: J1.2, J1.3, J2.11, J2.13, J2.14, J3.1, J3.2, J3.3, J3.4, J3.5, J3.6, J3.7, J3.8, R2.2, R5.1, U1.4, U2.2, U2.4, U2.5
unnamed: J1.1, R3.2
unnamed: R1.1, R2.1, R4.2
unnamed: R3.1, R5.2, U1.3
unnamed: R4.1, R6.2, U1.2
unnamed: R6.1, U1.6, U2.3
unnamed: R7.1, U2.1
unnamed: R7.2, U2.8
