CV19CO/open_controller_for_ventilator/403SFM3020_sensor/403SFM3020_sensor_module.kicad_pcb

## KiCad design 403SFM3020_sensor/403SFM3020_sensor_module.kicad_pcb (2022-05-27)

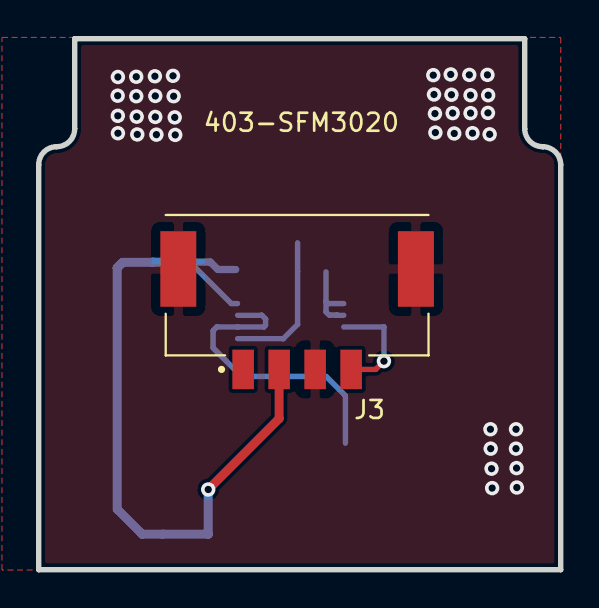
[picture p45: board 403SFM3020_sensor_module.kicad_pcb from above]

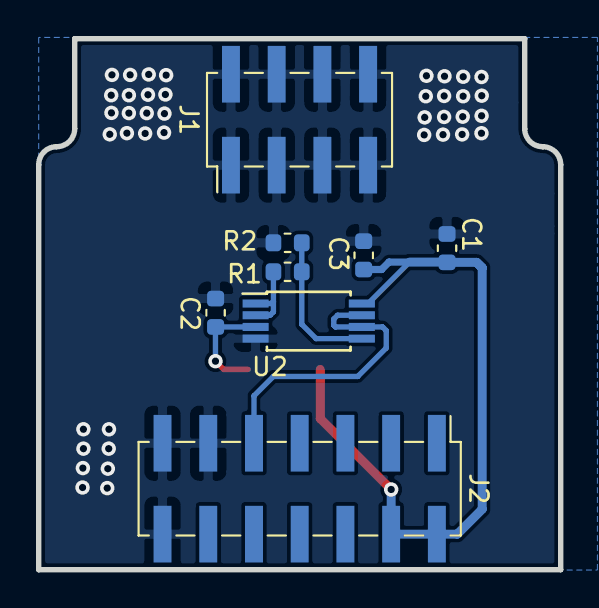
[picture p46: board 403SFM3020_sensor_module.kicad_pcb from below]

Board: 4 copper layers, 29.0 x 29.5 mm, 9 parts (8 on the bottom side), 7 nets.

Parts:
C1, C3: 0.1u; C_0603_1608Metric
C2: 1n; C_0603_1608Metric
J1: Conn_02x04_Odd_Even; PinHeader_2x04_P2.54mm_Vertical_SMD
J2: Conn_02x07_Odd_Even; PinHeader_2x07_P2.54mm_Vertical_SMD
J3: Conn_01x05_Female; MOLEX_5600200430
R1: 11k3; R_0603_1608Metric
R2: 22k; R_0603_1608Metric
U2: LM358; TSSOP-8_4.4x3mm_P0.65mm

Connections:
+3V3: J2.1, J2.3
+5V: C1.1, C3.1, J2.2, J2.4, J3.2, U2.8
/Analog: J2.9, U2.6, U2.7
GND: C1.2, C2.2, C3.2, J1.1, J1.2, J1.3, J1.4, J1.5, J1.6, J1.7, J1.8, J2.11, J2.13, J2.14, J3.3, J3.S1, J3.S2, R2.2, U2.4
unnamed: C2.1, J3.4, U2.3
unnamed: R1.1, R2.1, U2.5
unnamed: R1.2, U2.1, U2.2
