CV19CO/open_controller_for_ventilator/ABPDJJT001PDSA3_sensor/ABPDJJT001PDSA3_sensor_module.kicad_pcb

## KiCad design ABPDJJT001PDSA3_sensor/ABPDJJT001PDSA3_sensor_module.kicad_pcb (2022-02-02)

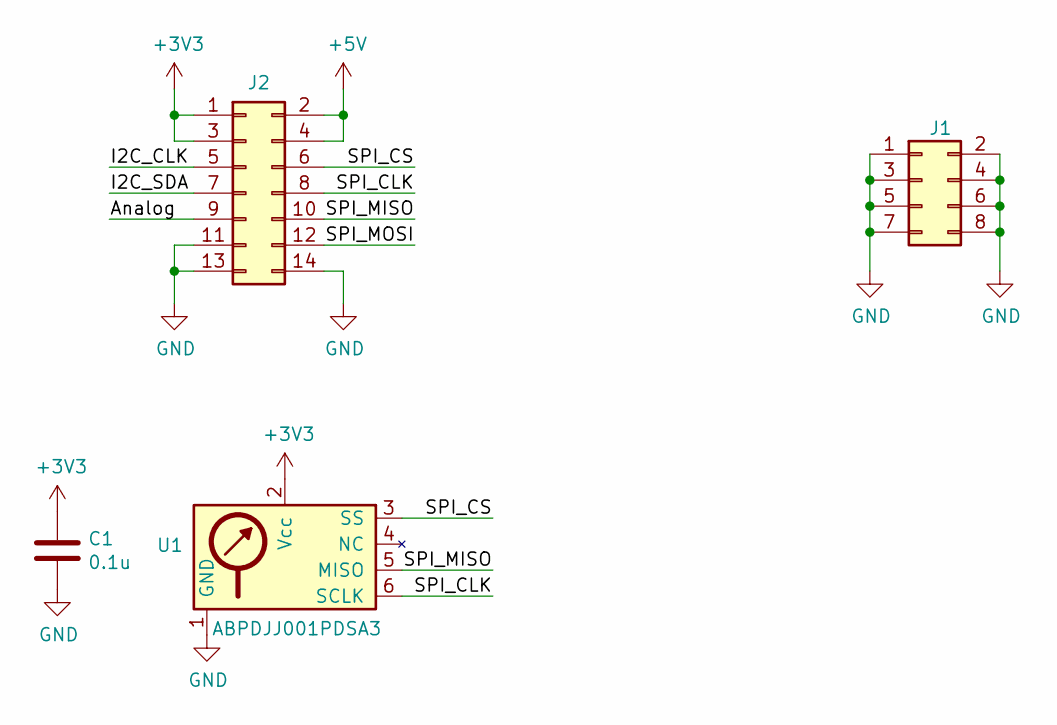
[picture p47: schematic ABPDJJT001PDSA3_sensor_module.sch, Pressure sensor module]

Parts:
C1: 0.1u; C_0603_1608Metric; DigiKey 1276-1258-1-ND
J1: Conn_02x04_Odd_Even; PinHeader_2x04_P2.54mm_Vertical_SMD; DigiKey 609-6367-ND
J2: Conn_02x07_Odd_Even; PinHeader_2x07_P2.54mm_Vertical_SMD; DigiKey 609-6365-ND
U1: ABPDJJ001PDSA3; DIP_JJ

Connections:
+3V3: C1.1, J2.1, J2.3, U1.2 (Vcc)
+5V: J2.2, J2.4
/Analog: J2.9
/I2C_CLK: J2.5
/I2C_SDA: J2.7
/SPI_CLK: J2.8, U1.6 (SCLK)
/SPI_CS: J2.6, U1.3 (SS)
/SPI_MISO: J2.10, U1.5 (MISO)
/SPI_MOSI: J2.12
GND: C1.2, J1.1, J1.2, J1.3, J1.4, J1.5, J1.6, J1.7, J1.8, J2.11, J2.13, J2.14, U1.1 (GND)

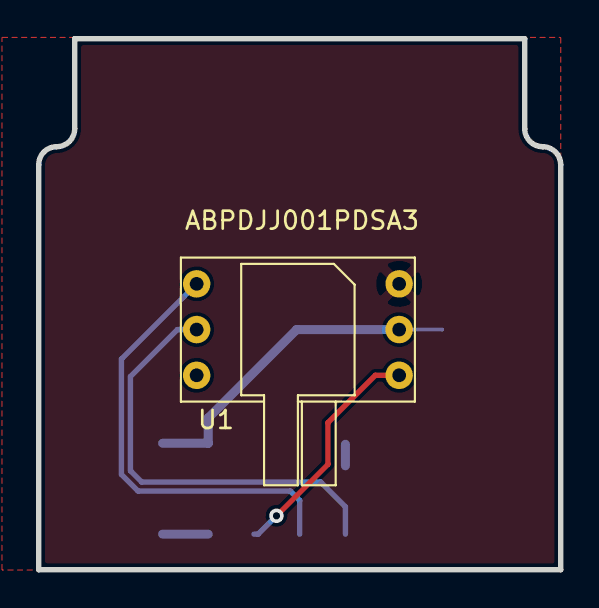
[picture p48: board ABPDJJT001PDSA3_sensor_module.kicad_pcb from above]

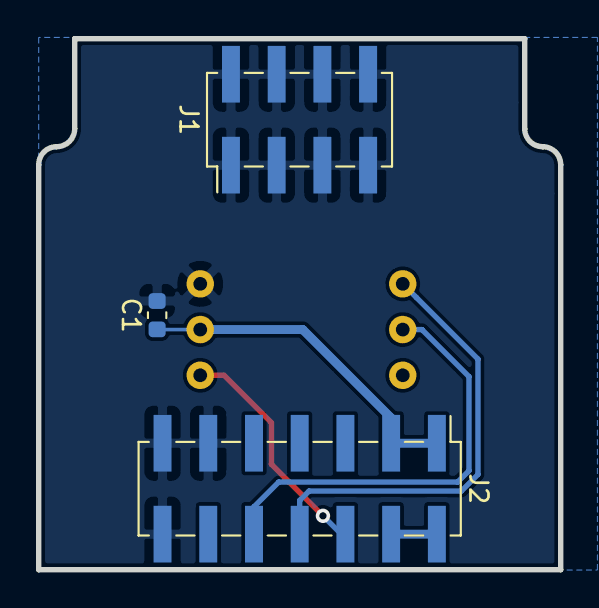
[picture p49: board ABPDJJT001PDSA3_sensor_module.kicad_pcb from below]

Board: 4 copper layers, 29.0 x 29.5 mm, 4 parts (3 on the bottom side), 6 nets.
