CV19CO/open_controller_for_ventilator/pcb_2.0/keep_breathing_ctrl.kicad_pcb

## KiCad design pcb_2.0/keep_breathing_ctrl.kicad_pcb (2021-09-30)

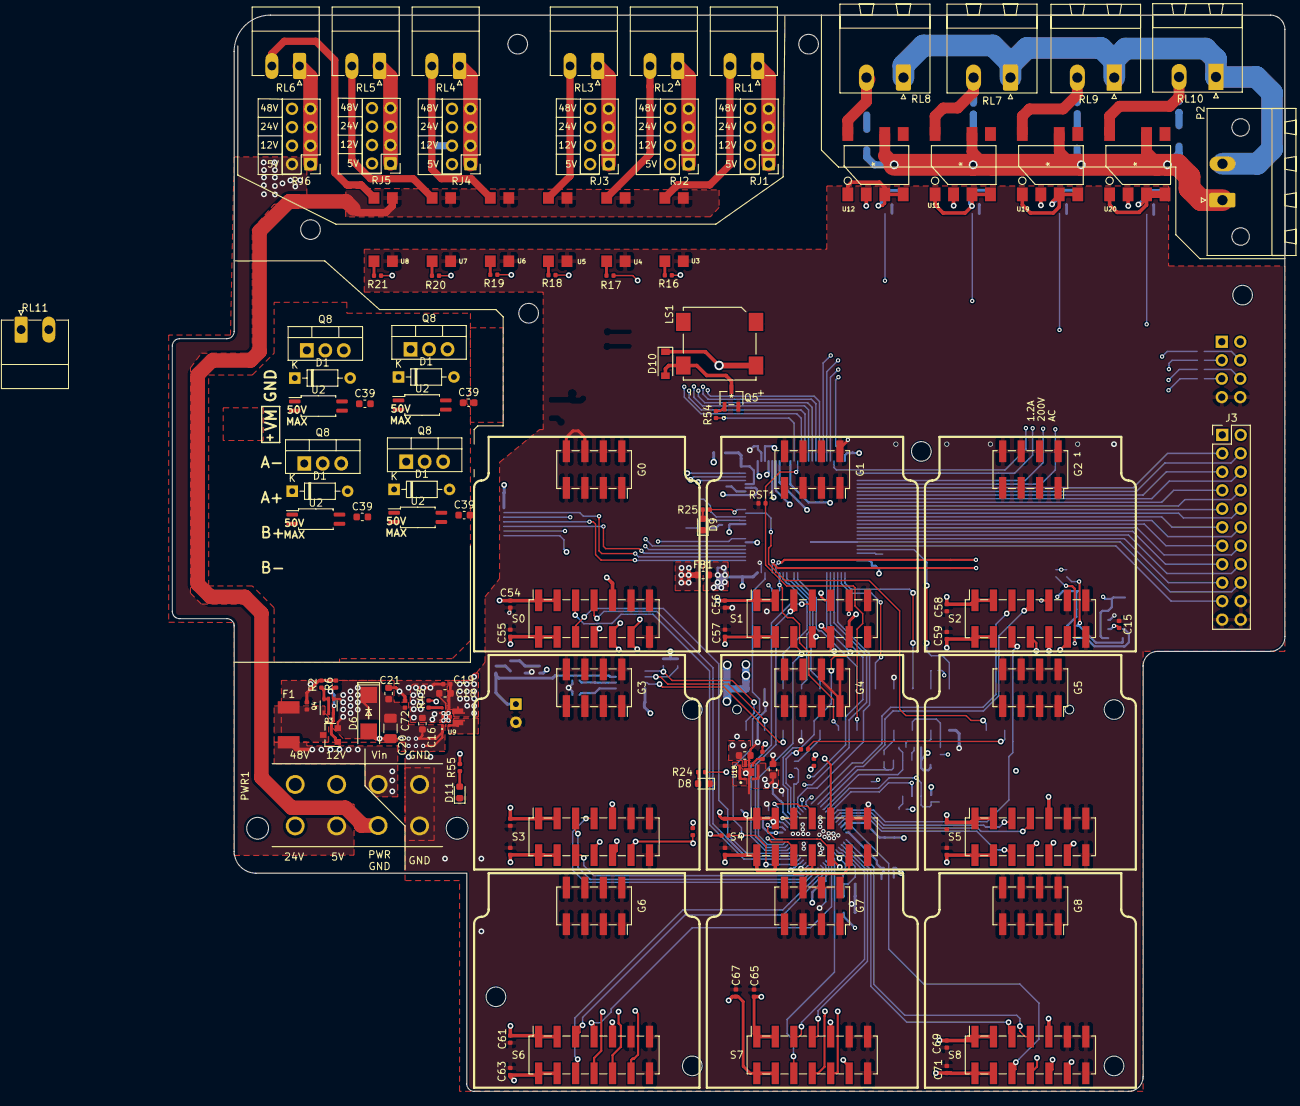
[picture p50: board keep_breathing_ctrl.kicad_pcb from above]

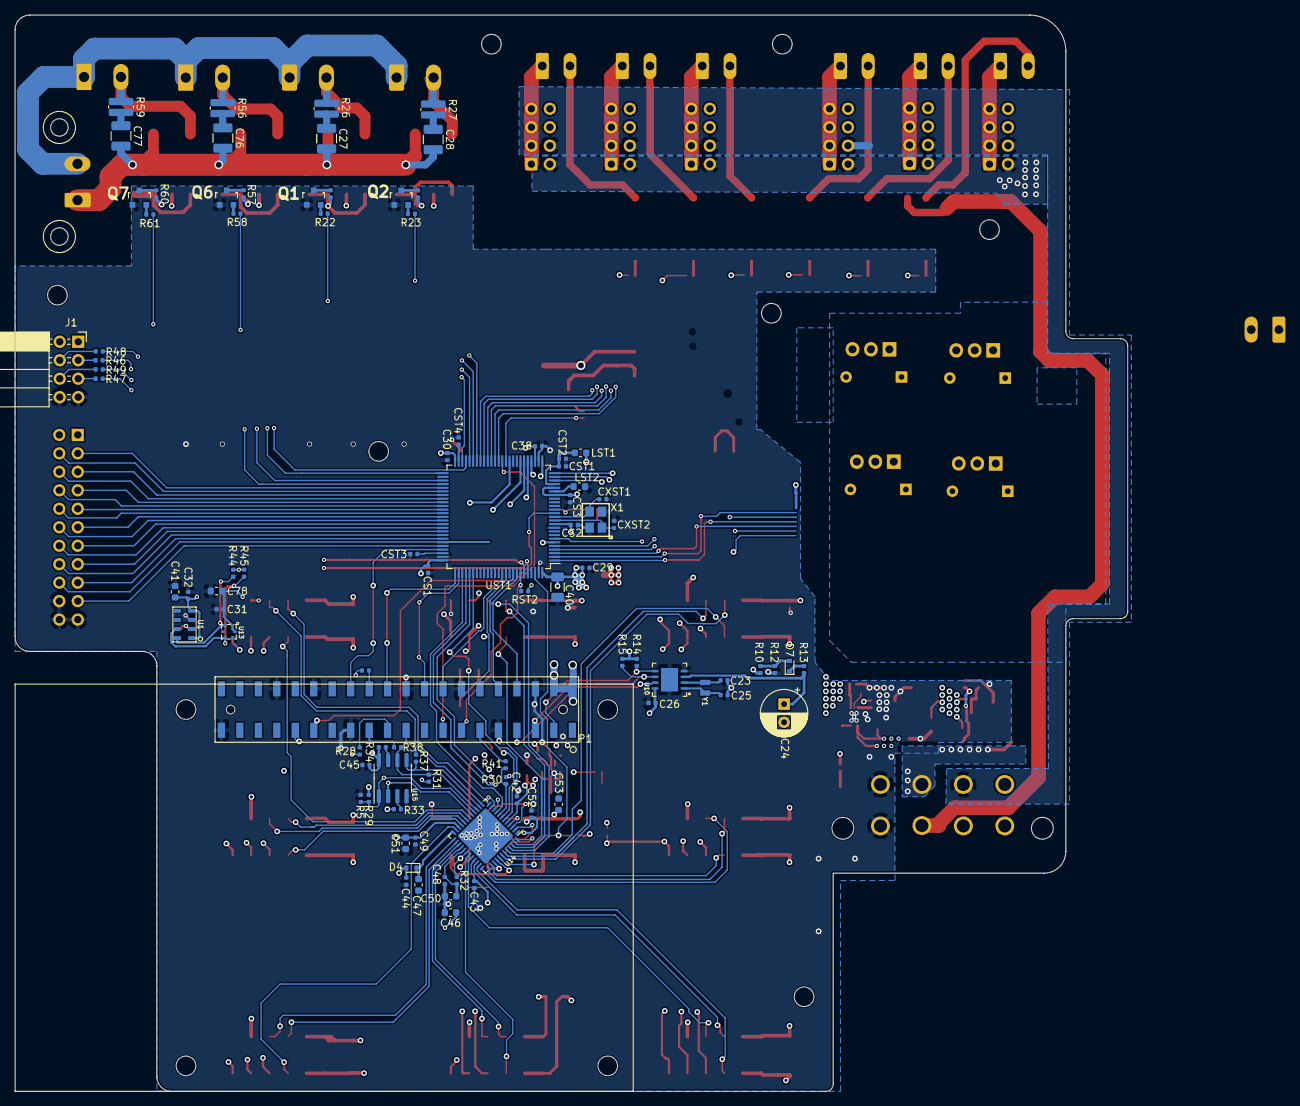
[picture p51: board keep_breathing_ctrl.kicad_pcb from below]

Board: 4 copper layers, 153.0 x 148.0 mm, 226 parts (91 on the bottom side), 190 nets.

Parts:
C15, C31, C32: 100nF; C_0402_1005Metric
C16, C18: 10u; C_0603_1608Metric
C17: 1uF; C_0402_1005Metric
C19, C42, C44: 0.1u; C_0402_1005Metric
C20: 100uF; R_1206_3216Metric
C21: 47uF; R_0603_1608Metric
C23, C25: 4pF; C_0402_1005Metric
C24: JUWT1105MCD; CP_Radial_D6.3mm_P2.50mm
C26, C29, C30, C38, C54, C55, C56, C57, C58, C59, C60, C61, C62, C63, C64, C65, C66, C67, C68, C69, C70, C71: 0.1uF; C_0402_1005Metric
C27, C28, C76, C77: 0.1u 250V; C_1210_3225Metric
C39, C39#2, C39#3, C39#4: 1uF; C_0603_1608Metric
C40: 4.7uF; C_1206_3216Metric
C41, C75, C78: 10uF; C_0603_1608Metric
C43, C45, C48, C49, C52: 0.1u; R_0402_1005Metric
C46, C50, C51, C53: 4.7u; R_0603_1608Metric
C47, C73: 4.7u; C_0603_1608Metric
C72: 100nF; R_0402_1005Metric
CS1, CS2, CS3: 0.1uF; C_0402_1005Metric
CST1: 0.1uF; C_0402_1005Metric
CST2: 1uF; C_0402_1005Metric
CST3, CST4: 2.2uF; C_0402_1005Metric
CXST1, CXST2: 22pF; C_0402_1005Metric
D1, D1#2, D1#3, D1#4: 1N4148; D_DO-35_SOD27_P7.62mm_Horizontal
D4: CDBU0520; D_SOD-523
D6: SMBJ5.0A-TR; DO-214AA
D7: 1SS389,L3F; D_SOD-523
D8, D9, D11: LED; LED_0603_1608Metric
D10: 1N4148; D_SOD-123
F1: MF-MSMF250/X; PTC
FB1: Ferrite_Bead_Small; R_0603_1608Metric
G0, G1, G2, G3, G4, G5, G6, G7, G8: Conn_01x03; PinSocket_2x04_P2.54mm_Vertical_SMD
H1, H2, H3, H4, H5, H6, H7, H8, H9, H10, H11: MountingHole; MountingHole_2.7mm_M2.5
J1: Conn_02x04_Odd_Even; PinSocket_2x04_P2.54mm_Horizontal
J3: Conn_02x11_Odd_Even; PinHeader_2x11_P2.54mm_Vertical
LS1: CSS-95B30-SMT; CUI_CSS-95B30-SMT
LST1, LST2: 2A 120 ohm; R_0603_1608Metric
P1: CONN_RASPBERRY; SMD_CONN_2x20
P2: Conn_01x04_Female; PhoenixContact_MSTB_2,5_2-GF_1x02_P5.00mm_Horizontal_Thread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
PWR1: Conn_01x03; 10142708-08200LF
Q1, Q2, Q6, Q7: PN2222; SOT23_Transistor
Q3: DMG2305UX; SOT-23
Q4: BCM857BS; SOT-363_SC-70-6
Q5: 2SC3325-Y
Q8, Q8#2, Q8#3, Q8#4: IRF540N; TO-220-3_Vertical
R2, R42, R43, R44, R45: 10k; R_0402_1005Metric
R5, R29, R30, R31, R33, R34, R50, R51, R53: 10K; R_0402_1005Metric
R6: 47k; R_0402_1005Metric
R10: 450; R_0402_1005Metric
R12: 500; R_0402_1005Metric
R13, R28, R32, R37, R38, R40, R41, R46, R47, R48, R49, R52: 100; R_0402_1005Metric
R14, R15: 2.2k; R_0402_1005Metric
R16, R17, R18, R19, R20, R21, R23, R61: 200; R_0402_1005Metric
R22, R58: 330; R_0402_1005Metric
R24, R25, R55: 1k; R_0402_1005Metric
R26, R27, R56, R59: 100 1/2W; R_0612_1632Metric
R35, R36, R57, R60: 22; R_0402_1005Metric
R54: 180; R_0402_1005Metric
RJ1, RJ2, RJ3, RJ4, RJ5, RJ6: Conn_02x04_Odd_Even; PinHeader_2x04_P2.54mm_Vertical
RL1, RL2, RL3, RL4, RL5, RL6, RL11: Conn_01x04_Female; PhoenixContact_MC_1,5_2-G-3.81_1x02_P3.81mm_Horizontal
RL7, RL8, RL9, RL10: Conn_01x04_Female; PhoenixContact_MSTBA_2,5_2-G-5,08_1x02_P5.08mm_Horizontal
RST1, RST2: 10k; R_0402_1005Metric
S0, S1, S2, S3, S4, S5, S6, S7, S8: Conn_02x07_Counter_Clockwise; PinSocket_2x07_P2.54mm_Vertical_SMD
U1: MPL3115A2; 8LGA
U2, U2#2, U2#3, U2#4: TLP291; SOIC-4_4.55x2.6mm_P1.27mm
U3, U4, U5, U6, U7, U8: TLP240D; TLP240D_TP1
U9: XCL214B333; TOREX_XCL214B123DR
U10: PCF8523TK; HVSON8
U11, U12, U19, U20: AQH3223AX; AQH3223A
U13: HTS221; HLGA-6L
U14: ICE40UP5K-SG48ITR; QFN-48-1EP_7x7mm_P0.5mm_EP5.6x5.6mm
U15: GD25Q32CTIGR-Memory_Flash; SOIC-8_3.9x4.9mm_P1.27mm
U18: XCL206B123; CL-2025-02
UST1: STM32F427VIT6; LQFP-100_14x14mm_P0.5mm
X1: ABM8G
Y1: ABS06-107-32.768KHZ-T; ABS06-107

Connections:
1V2_ICE: C42.1, C75.1, R32.2, U14.5, U14.30, U18.3, U18.8
3V3_STM: C29.1, C30.1, C38.1, C39#4.1, C40.1, CS1.1, CS2.1, CS3.1, FB1.2, LST1.1, RST2.1, UST1.6, UST1.11, UST1.19, UST1.21, UST1.28, UST1.50, UST1.75, UST1.100
5V_R: PWR1.5, RJ1.2, RJ2.2, RJ3.2, RJ4.2, RJ5.2, RJ6.2
12V_R: PWR1.6, RJ1.4, RJ2.4, RJ3.4, RJ4.4, RJ5.4, RJ6.4
24V_R: PWR1.7, RJ1.6, RJ2.6, RJ3.6, RJ4.6, RJ5.6, RJ6.6
48V_R: PWR1.8, RJ1.8, RJ2.8, RJ3.8, RJ4.8, RJ5.8, RJ6.8
+2V5: C47.1, D4.1, U14.24
+3V3: C18.1, C19.1, C26.2, C31.1, C32.1, C41.1, C43.1, C44.1, C45.1, C46.1, C49.1, C51.1, C52.1, C53.1, C54.1, C56.1, C58.1, C60.1, C61.1, C64.1, C65.1, C68.1, C69.1, C78.1, D4.2, FB1.1, J1.1, J3.1, R14.2, R15.2, R29.2, R30.2, R31.2, R33.2, R34.2, R44.1, R45.1, R50.2, R51.2, R53.2, S0.1, S0.3, S1.1, S1.3, S2.1, S2.3, S3.1, S3.3, S4.1, S4.3, S5.1, S5.3, S6.1, S6.3, S7.1, S7.3, S8.1, S8.3, U1.1, U1.4, U9.4, U9.9, U10.8, U11.2, U12.2, U13.1, U13.6, U14.1, U14.22, U14.33, U15.8, U19.2, U20.2
+5V: C16.1, C20.1, C21.1, C55.1, C57.1, C59.1, C62.1, C63.1, C66.1, C67.1, C70.1, C71.1, C72.1, C73.1, D6.1, D10.1, J1.2, J3.2, LS1.P, P1.2, P1.4, Q3.2, Q4.4, R10.2, R42.2, R43.2, R55.2, S0.2, S0.4, S1.2, S1.4, S2.2, S2.4, S3.2, S3.4, S4.2, S4.4, S5.2, S5.4, S6.2, S6.4, S7.2, S7.4, S8.2, S8.4, U9.1, U18.6
/I2C/I2C_SCL: P1.5, R15.1, U10.6
/I2C/I2C_SDA: P1.3, R14.1, U10.5
/PSU/L1_Lx_1V2: U18.1, U18.7
/PSU/L1_Lx_3V3: U9.3, U9.8
/PSU/Q3S: C17.1, F1.2, Q3.3, Q4.1
/PSU/Vin: F1.1, PWR1.4
/Rapsberry/BOOT0: P1.13, RST2.2, UST1.94
/Rapsberry/BOOT1: P1.15, RST1.2, UST1.37
/Rapsberry/ICE_DONE: P1.31, R52.1
/Rapsberry/INT_RTC: P1.7, U10.7
/Rapsberry/JNRST: P1.12, UST1.90
/Rapsberry/JTCK: P1.22, UST1.76
/Rapsberry/JTDI: P1.18, UST1.77
/Rapsberry/JTDO: P1.16, UST1.89
/Rapsberry/JTMS: P1.26, UST1.72
/Rapsberry/MCU_NRST: P1.29, UST1.14
/Rapsberry/RST_ICE: P1.11, R41.1
/Rapsberry/RX_PI: P1.10, UST1.92
/Rapsberry/SPI_CLK: P1.23, R38.1
/Rapsberry/SPI_CS: P1.24, R40.1
/Rapsberry/SPI_MISO: P1.21, R28.1
/Rapsberry/SPI_MOSI: P1.19, R37.1
/STM32F4/Buzzer: R54.2, UST1.36
/STM32F4/LED: R25.2, UST1.15
/STM32F4/PA8: J3.15, UST1.67
/STM32F4/PA9: J3.16, UST1.68
/STM32F4/PA10: J3.17, UST1.69
/STM32F4/PA11: J3.18, UST1.70
/STM32F4/PA12: J3.19, UST1.71
/STM32F4/PC6: J3.11, UST1.63
/STM32F4/PC7: J3.12, UST1.64
/STM32F4/PC8: J3.13, UST1.65
/STM32F4/PC9: J3.14, UST1.66
/STM32F4/PD8: J3.3, UST1.55
/STM32F4/PD9: J3.4, UST1.56
/STM32F4/PD10: J3.5, UST1.57
/STM32F4/PD11: J3.6, UST1.58
/STM32F4/PD12: J3.7, UST1.59
/STM32F4/PD13: J3.8, UST1.60
/STM32F4/PD14: J3.9, UST1.61
/STM32F4/PD15: J3.10, UST1.62
/STM32F4/P_EV7: R21.2, UST1.38
/STM32F4/P_EV8: R20.2, UST1.39
/STM32F4/P_EV9: R19.2, UST1.40
/STM32F4/P_EV10: R18.2, UST1.41
/STM32F4/P_EV11: R17.2, UST1.42
/STM32F4/P_EV12: R16.2, UST1.43
/STM32F4/P_EV13: R23.2, UST1.44
/STM32F4/P_EV14: R22.2, UST1.45
/STM32F4/P_EV15: R58.2, UST1.46
/STM32F4/P_EV16: R61.2, UST1.48
/STM32F4/SPI2_MISO: R49.1, UST1.53
/STM32F4/SPI2_MOSI: R47.2, UST1.54
/STM32F4/SPI2_NSS_0: R46.2, UST1.51
/STM32F4/SPI2_SCK: R48.1, UST1.47
/STM32F4/SPI3_MISO: U14.10, UST1.79
/STM32F4/SPI3_MOSI: U14.11, UST1.80
/STM32F4/SPI3_NSS: U14.6, UST1.81
/STM32F4/SPI3_SCK: U14.9, UST1.78
/STM32F4/SPI4_NSS_1: R53.1, U14.41, UST1.98
/STM32F4/STM_UART_RX: P1.8, UST1.93
/STM32F4/VDDAST: CST1.1, CST2.1, LST1.2, UST1.22
/SensorShields/ANALOG_0: S0.9, UST1.25
/SensorShields/ANALOG_1: S1.9, UST1.26
/SensorShields/ANALOG_2: S2.9, UST1.35
/SensorShields/ANALOG_3: S3.9, UST1.24
/SensorShields/ANALOG_4: S4.9, UST1.29
/SensorShields/ANALOG_5: S5.9, UST1.32
/SensorShields/ANALOG_6: S6.9, UST1.23
/SensorShields/ANALOG_7: S7.9, UST1.30
/SensorShields/ANALOG_8: S8.9, UST1.31
/SensorShields/CDONE: R24.2, R52.2, U14.7
/SensorShields/CRESET_N: R30.1, R41.2, U14.8
/SensorShields/FPGA_SI: R28.2, U14.17, U15.2
/SensorShields/FPGA_SO: R37.2, U14.14, U15.5
/SensorShields/FT_SCK: R31.1, R38.2, U14.15, U15.6
/SensorShields/FT_SSn: R5.2, R29.1, R40.2, U14.16, U15.1
/SensorShields/I2C_CLK_0: S0.5, U14.42
/SensorShields/I2C_CLK_1: S1.5, U14.46
/SensorShields/I2C_CLK_2: S2.5, U14.12
/SensorShields/I2C_CLK_3: S3.5, U14.37
/SensorShields/I2C_CLK_4: S4.5, U14.4
/SensorShields/I2C_CLK_5: S5.5, U14.19
/SensorShields/I2C_CLK_6: S6.5, U14.34
/SensorShields/I2C_CLK_7: S7.5, U14.28
/SensorShields/I2C_CLK_8: S8.5, U14.26
/SensorShields/I2C_SDA_0: S0.7, U14.43
/SensorShields/I2C_SDA_1: S1.7, U14.45
/SensorShields/I2C_SDA_2: S2.7, U14.13
/SensorShields/I2C_SDA_3: S3.7, U14.36
/SensorShields/I2C_SDA_4: S4.7, U14.3
/SensorShields/I2C_SDA_5: S5.7, U14.20
/SensorShields/I2C_SDA_6: S6.7, U14.32
/SensorShields/I2C_SDA_7: S7.7, U14.27
/SensorShields/I2C_SDA_8: S8.7, U14.25
/SensorShields/SPI_CLK: R50.1, S0.8, S1.8, S2.8, S3.8, S4.8, S5.8, S6.8, S7.8, S8.8, U14.39
/SensorShields/SPI_CS_0: S0.6, U14.44
/SensorShields/SPI_CS_1: S1.6, U14.47
/SensorShields/SPI_CS_2: S2.6, U14.18
/SensorShields/SPI_CS_3: S3.6, U14.38
/SensorShields/SPI_CS_4: S4.6, U14.48
/SensorShields/SPI_CS_5: S5.6, U14.21
/SensorShields/SPI_CS_6: S6.6, U14.35
/SensorShields/SPI_CS_7: S7.6, U14.31
/SensorShields/SPI_CS_8: S8.6, U14.23
/SensorShields/SPI_MISO: S0.10, S1.10, S2.10, S3.10, S4.10, S5.10, S6.10, S7.10, S8.10, U14.2
/SensorShields/SPI_MOSI: R51.1, S0.12, S1.12, S2.12, S3.12, S4.12, S5.12, S6.12, S7.12, S8.12, U14.40
/SensorShields/VCC_PLL: C48.1, C50.1, R32.1, U14.29
/Sensors/SCL: R44.2, U1.8, U13.2, UST1.95
/Sensors/SDA: R45.2, U1.7, U13.4, UST1.96
GND: C15.2, C16.2, C17.2, C18.2, C19.2, C20.2, C21.2, C23.1, C24.2, C25.2, C26.1, C29.2, C30.2, C31.2, C32.2, C38.2, C39#4.2, C40.2, C41.2, C42.2, C43.2, C44.2, C45.2, C46.2, C47.2, C48.2, C49.2, C50.2, C51.2, C52.2, C53.2, C54.2, C55.2, C56.2, C57.2, C58.2, C59.2, C60.2, C61.2, C62.2, C63.2, C64.2, C65.2, C66.2, C67.2, C68.2, C69.2, C70.2, C71.2, C72.2, C73.2, C75.2, C78.2, CS1.2, CS2.2, CS3.2, CST1.2, CST2.2, CST3.1, CST4.1, CXST1.2, CXST2.2, D6.2, D8.1, D9.1, D11.1, G0.1, G0.2, G0.3, G0.4, G0.5, G0.6, G0.7, G0.8, G1.1, G1.2, G1.3, G1.4, G1.5, G1.6, G1.7, G1.8, G2.1, G2.2, G2.3, G2.4, G2.5, G2.6, G2.7, G2.8, G3.1, G3.2, G3.3, G3.4, G3.5, G3.6, G3.7, G3.8, G4.1, G4.2, G4.3, G4.4, G4.5, G4.6, G4.7, G4.8, G5.1, G5.2, G5.3, G5.4, G5.5, G5.6, G5.7, G5.8, G6.1, G6.2, G6.3, G6.4, G6.5, G6.6, G6.7, G6.8, G7.1, G7.2, G7.3, G7.4, G7.5, G7.6, G7.7, G7.8, G8.1, G8.2, G8.3, G8.4, G8.5, G8.6, G8.7, G8.8, J1.7, J1.8, J3.20, J3.21, J3.22, LST2.2, P1.6, P1.9, P1.14, P1.20, P1.25, P1.30, P1.34, P1.39, PWR1.1, PWR1.2, Q1.1, Q2.1, Q5.2, Q6.1, Q7.1, R2.2, R5.1, R6.2, R12.1, RST1.1, S0.11, S0.13, S0.14, S1.11, S1.13, S1.14, S2.11, S2.13, S2.14, S3.11, S3.13, S3.14, S4.11, S4.13, S4.14, S5.11, S5.13, S5.14, S6.11, S6.13, S6.14, S7.11, S7.13, S7.14, S8.11, S8.13, S8.14, U1.3, U2#4.2, U3.2, U4.2, U5.2, U6.2, U7.2, U8.2, U9.5, U9.7, U10.4, U10.PAD, U13.5, U14.49, U15.4, U18.2, U18.5, U18.PAD, UST1.10, UST1.27, UST1.74, UST1.99, X1.2, X1.4
GNDPWR: PWR1.3, Q8#4.3, U3.3, U4.3, U5.3, U6.3, U7.3, U8.3
LINE: P2.2, RL7.1, RL8.1, RL9.1, RL10.1
NEUT: C27.2, C28.2, C76.2, C77.2, P2.1, U11.6, U12.6, U19.6, U20.6
unnamed: C15.1, U1.2
unnamed: C23.2, U10.2, Y1.1
unnamed: C24.1, R13.1, U10.3
unnamed: C25.1, U10.1, Y1.2
unnamed: C27.1, R26.2
unnamed: C28.1, R27.2
unnamed: C76.1, R56.2
unnamed: C77.1, R59.2
unnamed: CST3.2, UST1.73
unnamed: CST4.2, UST1.49
unnamed: CXST1.1, UST1.13, X1.3
unnamed: CXST2.1, UST1.12, X1.1
unnamed: D1#4.1, RL11.1
unnamed: D1#4.2, Q8#4.2, RL11.2
unnamed: D7.1, R13.2
unnamed: D7.2, R10.1, R12.2
unnamed: D8.2, R24.1
unnamed: D9.2, R25.1
unnamed: D10.2, LS1.N, Q5.3
unnamed: D11.2, R55.1
unnamed: J1.3, R46.1
unnamed: J1.4, R48.2
unnamed: J1.5, R47.1
unnamed: J1.6, R49.2
unnamed: LST2.1, UST1.20
unnamed: Q1.2, R22.1
unnamed: Q1.3, R35.2
unnamed: Q2.2, R23.1
unnamed: Q2.3, R36.2
unnamed: Q3.1, Q4.3, R6.1
unnamed: Q4.2, Q4.5, Q4.6, R2.1
unnamed: Q5.1, R54.1
unnamed: Q6.2, R58.1
unnamed: Q6.3, R57.2
unnamed: Q7.2, R61.1
unnamed: Q7.3, R60.2
unnamed: Q8#4.1, U2#4.3
unnamed: R16.1, U3.1
unnamed: R17.1, U4.1
unnamed: R18.1, U5.1
unnamed: R19.1, U6.1
unnamed: R20.1, U7.1
unnamed: R21.1, U8.1
unnamed: R26.1, RL7.2, U11.8
unnamed: R27.1, RL8.2, U12.8
unnamed: R33.1, U15.3
unnamed: R34.1, U15.7
unnamed: R35.1, U11.1, U11.3, U11.4
unnamed: R36.1, U12.1, U12.3, U12.4
unnamed: R42.1, U18.4
unnamed: R43.1, U9.6
unnamed: R56.1, RL9.2, U19.8
unnamed: R57.1, U19.1, U19.3, U19.4
unnamed: R59.1, RL10.2, U20.8
unnamed: R60.1, U20.1, U20.3, U20.4
unnamed: RJ1.1, RJ1.3, RJ1.5, RJ1.7, RL1.1
unnamed: RJ2.1, RJ2.3, RJ2.5, RJ2.7, RL2.1
unnamed: RJ3.1, RJ3.3, RJ3.5, RJ3.7, RL3.1
unnamed: RJ4.1, RJ4.3, RJ4.5, RJ4.7, RL4.1
unnamed: RJ5.1, RJ5.3, RJ5.5, RJ5.7, RL5.1
unnamed: RJ6.1, RJ6.3, RJ6.5, RJ6.7, RL6.1
unnamed: RL1.2, U3.4
unnamed: RL2.2, U4.4
unnamed: RL3.2, U5.4
unnamed: RL4.2, U6.4
unnamed: RL5.2, U7.4
unnamed: RL6.2, U8.4
