CV19CO/open_controller_for_ventilator/(commit log)

2020-04-08 solid state relays
    [ESP32.sch, ElectroValves.sch, PAN_AQY21-SO4-L.step, PAN_AQY21-SO4-M.step, PAN_AQY21-SO4.step, TLP240D_TP1.step, keep_breathing_ctrl.kicad_pcb, keep_breathing_ctrl.sch]
2020-04-08 Pi mh
    [ElectroValves.sch, keep_breathing_ctrl.kicad_pcb, keep_breathing_ctrl.sch, power_stepper.sch]
2020-04-08 cap flipped
    [keep_breathing_ctrl.kicad_pcb, keep_breathing_ctrl.sch]
2020-04-08 Pi3 added
    [keep_breathing_ctrl.kicad_pcb, raspberryPi3BSimplified_STEP.STEP]
2020-04-08 supply schema
    [supply.sch]
2020-04-09 added barrel_connector and 3v3 reg libraries, added connections on supply sheet
    [ESP32.sch, supply.sch]
2020-04-09 added power connections and a led
    [ESP32.sch]
2020-04-09 clean up
    [ESP32.sch, ElectroValves.sch, keep_breathing_ctrl.sch, power_stepper.sch, supply.sch]
2020-04-09 rtc added
    [ESP32.sch, ElectroValves.sch, I2C.sch, keep_breathing_ctrl.sch, power_stepper.sch, supply.sch]
2020-04-09 RTC to PCB
    [ESP32.sch, HVSON8.step, I2C.sch, keep_breathing_ctrl.kicad_pcb, keep_breathing_ctrl.sch, supply.sch]
2020-04-09 AQH3213AX added
    [ElectroValves.sch]
2020-04-10 added miscellaneous to electro valves sheet
    [ESP32.sch, ElectroValves.sch, I2C.sch, keep_breathing_ctrl.sch, power_stepper.sch, supply.sch]
2020-04-10 AQH3213AX footprint fixed
    [ESP32.sch, ElectroValves.sch, I2C.sch, keep_breathing_ctrl.kicad_pcb, keep_breathing_ctrl.sch, power_stepper.sch, supply.sch]
2020-04-10 3d model for phototriac
    [keep_breathing_ctrl.kicad_pcb]
2020-04-10 I/O EXPANDER added
    [ElectroValves.sch, keep_breathing_ctrl.kicad_pcb]
2020-04-10 Made symbol paths relative to project's root
    [keep_breathing_ctrl.kicad_pcb]
2020-04-10 connecting relays to the i2c-gpios
    [ElectroValves.sch, keep_breathing_ctrl.kicad_pcb, keep_breathing_ctrl.sch]
2020-04-10 3D model for motor driver
    [VFQFPN_11x14x1mm.scad, keep_breathing_ctrl.kicad_pcb]
2020-04-12 connecting esp32 signals
    [ESP32.sch, keep_breathing_ctrl.kicad_pcb, keep_breathing_ctrl.sch, power_stepper.sch, supply.sch]
2020-04-12 added connections to ElectroValves sheet
    [CUI_PJ-002A.step, ESP32.sch, ElectroValves.sch, I2C.sch, SOT-223.step, keep_breathing_ctrl.sch, power_stepper.sch, supply.sch]
2020-04-12 added SOT-223 3d shape
    [keep_breathing_ctrl.kicad_pcb]
2020-04-12 pcb/keep_breathing_ctrl.kicad_pcb-bak removed
2020-04-12 led drive transistors
    [ESP32.sch, ElectroValves.sch, I2C.sch, keep_breathing_ctrl.kicad_pcb, keep_breathing_ctrl.sch, power_stepper.sch, supply.sch]
2020-04-13 Barrel jack 3d shape
    [keep_breathing_ctrl.kicad_pcb]
2020-04-13 added footprints in supply sheet
    [ESP32.sch, ElectroValves.sch, I2C.sch, keep_breathing_ctrl.sch, power_stepper.sch, supply.sch]
2020-04-13 Connections in the schema were modified and components some components from supply and electrovalves were positioned on the PCB
    [ESP32.sch, ElectroValves.sch, keep_breathing_ctrl.kicad_pcb, keep_breathing_ctrl.sch, supply.sch]
2020-04-13 GND isolated for motor driver
    [ESP32.sch, ElectroValves.sch, I2C.sch, keep_breathing_ctrl.kicad_pcb, keep_breathing_ctrl.sch, power_stepper.sch, supply.sch]
2020-04-13 ISO7762 added
    [power_stepper.sch]
2020-04-13 UCC12040 added
    [power_stepper.sch]
2020-04-14 footprints for isolation
    [keep_breathing_ctrl.kicad_pcb, power_stepper.sch]
2020-04-14 powerstepper placement
    [keep_breathing_ctrl.kicad_pcb, power_stepper.sch]
2020-04-14 updating cooper pour
    [keep_breathing_ctrl.kicad_pcb]
2020-04-15 *.kicad_pcb were modified, a sheet was created for rapsberry connector
    [ESP32.sch, ElectroValves.sch, I2C.sch, Rapsberry.sch, keep_breathing_ctrl.kicad_pcb, keep_breathing_ctrl.sch, power_stepper.sch, supply.sch]
2020-04-16 STM32 added
    [ESP32.sch, ElectroValves.sch, I2C.sch, Rapsberry.sch, STM32.sch, keep_breathing_ctrl.kicad_pcb, keep_breathing_ctrl.sch, power_stepper.sch]
2020-04-16 Adición del STM32
    [stm32.sch]
2020-04-16 Adición del STM32F4
    [ESP32.sch, ElectroValves.sch, I2C.sch, Rapsberry.sch, SAM3N.sch, STM32.sch, keep_breathing_ctrl.sch, power_stepper.sch]
2020-04-16 STM32F4 fix
    [ESP32.sch, ElectroValves.sch, I2C.sch, Rapsberry.sch, SAM3N.sch, STM32.sch, keep_breathing_ctrl.sch, power_stepper.sch]
2020-04-16 connecting STM32
    [ElectroValves.sch, I2C.sch, Rapsberry.sch, STM32.sch, keep_breathing_ctrl.kicad_pcb, keep_breathing_ctrl.sch, power_stepper.sch, supply.sch]
2020-04-16 environmental sensors
2020-04-17 getting roo for sensors
    [Rapsberry.sch, keep_breathing_ctrl.kicad_pcb]
2020-04-18 sensor array started
    [ElectroValves.sch, FPGA_ICE40UP5K.sch, I2C.sch, Rapsberry.sch, STM32.sch, SensorShield.sch, Sensors.sch, keep_breathing_ctrl.kicad_pcb]
2020-04-18 array sensor improved
    [ElectroValves.sch, I2C.sch, Rapsberry.sch, STM32.sch, SensorShield.sch, Sensors.sch, keep_breathing_ctrl.kicad_pcb, keep_breathing_ctrl.sch]
2020-04-19 shield connector fixed:
    [SensorShield.sch, keep_breathing_ctrl.kicad_pcb]
2020-04-19 all i2c from shields to FPGA
    [SensorShield.sch, keep_breathing_ctrl.kicad_pcb]
2020-04-19 array of connectors replacment
    [SensorShield.sch, Sensors.sch, keep_breathing_ctrl.kicad_pcb]
2020-04-19 schematic simplified
    [SensorShield.sch, Sensors.sch, keep_breathing_ctrl.kicad_pcb, keep_breathing_ctrl.sch, supply.sch]
2020-04-20 stepper planes
    [Rapsberry.sch, STM32.sch, SensorShield.sch, Sensors.sch, keep_breathing_ctrl.kicad_pcb]
2020-04-20 added ice40 regulators
    [ElectroValves.sch, I2C.sch, Rapsberry.sch, STM32.sch, SensorShield.sch, Sensors.sch, keep_breathing_ctrl.sch, power_stepper.sch]
2020-04-20 SPI connections between FPGA, PI and FLASH
    [Rapsberry.sch, SensorShield.sch, keep_breathing_ctrl.sch]
2020-04-20 Added 3V3_STM in STM32F4 and supply sheets
    [STM32.sch, supply.sch]
2020-04-21 stm32 jtag connected
    [ElectroValves.sch, I2C.sch, Rapsberry.sch, STM32.sch, SensorShield.sch, Sensors.sch, keep_breathing_ctrl.kicad_pcb, keep_breathing_ctrl.sch]
2020-04-21 GND for motor driver
    [keep_breathing_ctrl.kicad_pcb]
2020-04-21 rtc placement
    [ABS06-107.STEP, I2C.sch, Sensors.sch, keep_breathing_ctrl.kicad_pcb, power_stepper.sch]
2020-04-21 support connectors
    [SensorShield.sch, keep_breathing_ctrl.kicad_pcb]
2020-04-22 spi flash placement
    [SensorShield.sch, keep_breathing_ctrl.kicad_pcb]
2020-04-22 FPGA rotation
    [keep_breathing_ctrl.kicad_pcb]
2020-04-22 routing i2c signals
    [keep_breathing_ctrl.kicad_pcb]
2020-04-22 SS_SPI_CLK shortcut fixed
    [ElectroValves.sch, I2C.sch, Rapsberry.sch, STM32.sch, SensorShield.sch, Sensors.sch, keep_breathing_ctrl.kicad_pcb, keep_breathing_ctrl.sch]
2020-04-23 improving shield stability
    [ElectroValves.sch, I2C.sch, Rapsberry.sch, STM32.sch, SensorShield.sch, Sensors.sch, keep_breathing_ctrl.kicad_pcb, keep_breathing_ctrl.sch]
2020-04-23 2.5V diode placement
    [SensorShield.sch, keep_breathing_ctrl.kicad_pcb]
2020-04-23 3v3_ice removed
    [ElectroValves.sch, I2C.sch, Rapsberry.sch, STM32.sch, SensorShield.sch, Sensors.sch, keep_breathing_ctrl.kicad_pcb, keep_breathing_ctrl.sch]
2020-04-23 fixing i2c sensors
    [I2C.sch, SensorShield.sch, Sensors.sch, keep_breathing_ctrl.kicad_pcb]
2020-04-23 small 1.2V reg
    [SensorShield.sch, XDFN4_1x1mm.scad, keep_breathing_ctrl.kicad_pcb, supply.sch]
2020-04-23 footprint fix
    [SensorShield.sch, keep_breathing_ctrl.kicad_pcb]
2020-04-23 SPI for sensor shield array
    [keep_breathing_ctrl.kicad_pcb]
2020-04-23 routing analog signals
    [STM32.sch, keep_breathing_ctrl.kicad_pcb]
2020-04-23 analog signals routed
    [STM32.sch, keep_breathing_ctrl.kicad_pcb]
2020-04-24 fixing RPi mounting holes
    [keep_breathing_ctrl.kicad_pcb]
2020-04-24 1.2v ldo changed
    [I2C.sch, keep_breathing_ctrl.kicad_pcb, supply.sch]
2020-04-25 solid state stm32's signals connected
    [STM32.sch, keep_breathing_ctrl.kicad_pcb]
2020-04-25 connecting SPI signals from STM32
    [STM32.sch, keep_breathing_ctrl.kicad_pcb, keep_breathing_ctrl.sch]
2020-04-25 routing spi from stepper driver
    [keep_breathing_ctrl.kicad_pcb]
2020-04-26 unconnected PSU
    [PSU.sch]
2020-04-26 protection circuit added
    [ElectroValves.sch, I2C.sch, PSU.sch, Rapsberry.sch, STM32.sch, SensorShield.sch, Sensors.sch, keep_breathing_ctrl.kicad_pcb]
2020-04-27 mounting holes
    [PSU.sch, keep_breathing_ctrl.kicad_pcb, keep_breathing_ctrl.sch]
2020-04-28 adding mounting holes
    [ElectroValves.sch, I2C.sch, PSU.sch, Rapsberry.sch, STM32.sch, SensorShield.sch, Sensors.sch, keep_breathing_ctrl.kicad_pcb]
2020-04-28 new 1.2V DC-DC
    [PSU.sch, keep_breathing_ctrl.kicad_pcb]
2020-04-28 3v3 torex reg
    [I2C.sch, PSU.sch, Rapsberry.sch, SensorShield.sch, keep_breathing_ctrl.kicad_pcb]
2020-04-28 torex dc-dc module
    [ElectroValves.sch, I2C.sch, PSU.sch, Rapsberry.sch, STM32.sch, SensorShield.sch, Sensors.sch, keep_breathing_ctrl.kicad_pcb]
2020-04-28 ferrite bead added
    [ElectroValves.sch, HTS221TR.STEP, I2C.sch, PSU.sch, Rapsberry.sch, STM32.sch, SensorShield.sch, Sensors.sch]
2020-04-28 XCL214 placement
    [PSU.sch, keep_breathing_ctrl.kicad_pcb]
2020-04-28 power connector
    [10142708-04xxxlf.stp, 10142708-06xxxlf.stp, PSU.sch, keep_breathing_ctrl.kicad_pcb]
2020-05-02 stepper motor connector changed
    [ElectroValves.sch, I2C.sch, PSU.sch, Rapsberry.sch, STM32.sch, SensorShield.sch, Sensors.sch, keep_breathing_ctrl.kicad_pcb]
2020-05-02 relays placement
    [ElectroValves.sch, I2C.sch, PSU.sch, Rapsberry.sch, STM32.sch, SensorShield.sch, Sensors.sch, keep_breathing_ctrl.kicad_pcb]
2020-05-04 routing isolators
    [STM32.sch, keep_breathing_ctrl.kicad_pcb, power_stepper.sch]
2020-05-04 updating planes
    [keep_breathing_ctrl.kicad_pcb, power_stepper.sch]
2020-05-04 UCC12040 fixed
    [keep_breathing_ctrl.kicad_pcb]
2020-05-05 fixing missed footprints
    [STM32.sch, Sensors.sch, keep_breathing_ctrl.kicad_pcb, keep_breathing_ctrl.sch, power_stepper.sch]
2020-05-05 decoupling caps for stm32
2020-05-05 i2c stuff
    [STM32.sch, keep_breathing_ctrl.kicad_pcb]
2020-05-05 nss connected
    [keep_breathing_ctrl.kicad_pcb]
2020-05-06 stm32 boot modes connected to the Pi
    [ElectroValves.sch, I2C.sch, PSU.sch, Rapsberry.sch, STM32.sch, SensorShield.sch, Sensors.sch, keep_breathing_ctrl.kicad_pcb]
2020-05-06 adding external spi
    [STM32.sch, keep_breathing_ctrl.kicad_pcb]
2020-05-06 relay VCC fixed
    [ElectroValves.sch, Rapsberry.sch, keep_breathing_ctrl.kicad_pcb, keep_breathing_ctrl.sch]
2020-05-07 recomendations from Carlos Camargo applied
    [ElectroValves.sch, STM32.sch, SensorShield.sch, keep_breathing_ctrl.kicad_pcb]
2020-05-07 2 CS for FPGA
    [Rapsberry.sch, STM32.sch, SensorShield.sch, keep_breathing_ctrl.kicad_pcb, keep_breathing_ctrl.sch]
2020-05-11 jumper for reley voltage selector
    [ElectroValves.sch, keep_breathing_ctrl.kicad_pcb]
2020-05-11 relay power from main conector
    [10142708-08xxxlf.stp, ElectroValves.sch, PSU.sch, keep_breathing_ctrl.kicad_pcb]
2020-05-11 improving cooper pours
    [keep_breathing_ctrl.kicad_pcb]
2020-05-11 buzzer added to libs
    [CUI_DEVICES_CEP-1112.step, CUI_DEVICES_CSS-95B30-SMT-TR.step, pxc_1757284_06_MSTBA-2-5-6-G-5-08_3D.stp]
2020-05-12 improving ground separation
    [STM32.sch, keep_breathing_ctrl.kicad_pcb]
2020-05-22 Solved connections showed wrong by ERC
    [ElectroValves.sch, I2C.sch, PSU.sch, Rapsberry.sch, STM32.sch, SensorShield.sch, Sensors.sch, keep_breathing_ctrl.sch]
2020-05-23 Buzzer circuit on schema
    [STM32.sch]
2020-05-23 Buzzer circuit on PCB
    [S-Mini-ZKN.STEP, STM32.sch, keep_breathing_ctrl.kicad_pcb]
2020-05-24 Solved problems with POWERSTEP01 footprint
    [STM32.sch, keep_breathing_ctrl.kicad_pcb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]
2020-05-24 Solved connection problem with XCL214B333DR and it was added 3 leds to the board
    [ElectroValves.sch, PSU.sch, STM32.sch, SensorShield.sch, keep_breathing_ctrl.kicad_pcb, power_stepper.sch]
2020-05-25 Changed 5V_r 12V 24V and 48V to thermal reliefs
    [keep_breathing_ctrl.kicad_pcb]
2020-05-25 Solved all troubles with Torex footprints and copper zones
    [keep_breathing_ctrl.kicad_pcb, power_stepper.sch]
2020-05-25 new fixed modules for TOREX_XCL2144B123DR and powerSTEP01
2020-05-25 Changed 3V3 and GND connections on STM32 and TOREX
    [keep_breathing_ctrl.kicad_pcb]
2020-05-25 changed position for capacitors on STM32
    [keep_breathing_ctrl.kicad_pcb]
2020-05-26 Changes on STM and ICE paths
    [keep_breathing_ctrl.kicad_pcb]
2020-06-03 Added two SSR AQH3223AX on schema
    [ElectroValves.sch]
2020-06-04 Added two SSR on PCB
    [keep_breathing_ctrl.kicad_pcb]
2020-06-05 Added all connections between STM and AQH3223. added pin header with GPIO from STM
    [ElectroValves.sch, STM32.sch, keep_breathing_ctrl.kicad_pcb, keep_breathing_ctrl.sch]
2020-06-07 Added 3d shape for connector clik-mate Added connection between STM and connector clik-mate on schema and PCB P3 is a connector that allows put a panic button for do a reset in the IC powerstep01
    [5024430470.stp, STM32.sch, keep_breathing_ctrl.kicad_pcb, keep_breathing_ctrl.sch, power_stepper.sch]
2020-06-09 Chaged P3 to SW1 and a new circuit to emergency reset on IC powerstep01 Added 3d shape for 2 contancs molex clik-mate connector
    [5024430270.stp, keep_breathing_ctrl.kicad_pcb, power_stepper.sch]
2020-06-25 Added the subproject pressure sensor module
    [pressure_sensor_module.sch]
2020-06-25 - Added Sensor_pressure library - Added 3d shape for MPX5100 sensor - MPX5100 footprint created - Connections on SEEschema for presure_sensor_module - Connections on PCBnew for pressure_sensor_module
    [MPX5100GP.STEP, keep_breathing_ctrl.kicad_pcb, pressure_sensor_module.kicad_pcb, pressure_sensor_module.sch, pressure_sensor_module.step]
2020-06-25 - Added footprint MPX100 vertical - Modified pinHeader footprints to SMD
    [pressure_sensor_module.kicad_pcb, pressure_sensor_module.sch, pressure_sensor_module.step]
2020-06-25 - Modified pin 1 to square in MPX5100 footprint - added another 3d shape for MPX 5100GP
    [MPX5100GP.step, pressure_sensor_module.kicad_pcb]
2020-07-02 added an LM358 to improve possible problems with impedance between the sensor and the STM
    [pressure_sensor_module.kicad_pcb, pressure_sensor_module.sch]
2020-07-02 Added readme.txt in pressure_sensor_module
2020-07-05 Only a plot for gerber files
    [keep_breathing_ctrl-B_Cu.gbr, keep_breathing_ctrl-B_Mask.gbr, keep_breathing_ctrl-B_Paste.gbr, keep_breathing_ctrl-B_SilkS.gbr, keep_breathing_ctrl-Edge_Cuts.gbr, keep_breathing_ctrl-F_Cu.gbr, keep_breathing_ctrl-F_Mask.gbr, keep_breathing_ctrl-F_Paste.gbr]
2020-07-09 Added footprint for ABPDJJ001PDSA3 sensor Created daugther PCB for ABPDJJ001PDSA3 sensor in EESchema and PCBnew
    [ABPDJJT001PDSA3_sensor_module.kicad_pcb, ABPDJJT001PDSA3_sensor_module.sch]
2020-07-10 Added daugther board for ABPDANT060MGAA5 sensor on EESchema and PCBnew Added ABPDANT060MGAA5 library and footprint
    [ABPDANT060MGAA5_sensor_module.kicad_pcb, ABPDANT060MGAA5_sensor_module.sch]
2020-07-10 Added board for ABPDANT015PGAA5 sensor added ABPDANT015PGAA5 lib
    [ABPDANT015PGAA5_sensor_module.kicad_pcb, ABPDANT015PGAA5_sensor_module.sch]
2020-07-10 Added DigiKey part number to J2 connector WM17456-ND
    [ABPDANT060MGAA5_sensor_module.sch]
2020-07-10 Added DigiKey part number
    [ABPDANT015PGAA5_sensor_module.sch]
2020-07-10 Added capacitors DigiKey part number
    [ABPDANT060MGAA5_sensor_module.sch]
2020-07-10 Added DigiKey parts number
    [pressure_sensor_module.sch]
2020-07-11 Added components dikey part numbers in modified sheets
    [I2C.sch, PSU.sch, Rapsberry.sch, STM32.sch, keep_breathing_ctrl.kicad_pcb, power_stepper.sch]
2020-07-11 Added basic shape 3d for ABPDJJ001PDSA3 sensor
    [ABPDJJT001PDSA3.stp, ABPDJJT001PDSA3_sensor_module.kicad_pcb]
2020-07-11 Added digiKey part number for some components
    [ElectroValves.sch, PSU.sch, STM32.sch, SensorShield.sch, Sensors.sch, power_stepper.sch]
2020-07-11 Added BOM for PCB ABPDANT015PGAA5 sensor
    [ABPDANT015PGAA5_sensor_module.sch, BOM_ABPDANT015PGAA5_sensor_module.csv]
2020-08-04 Added all references on silkscreen added BOM for sensor modules
    [ABPDANT060MGAA5_sensor_module.sch, ABPDJJT001PDSA3_sensor_module.sch, BOM_ABPDANT060MGAA5_sensor_module.csv, BOM_ABPDJJT001PDSA3_sensor_module.csv, BOM_keep_breathing_ctrl.csv, BOM_pressure_sensor_module.csv, ElectroValves.sch, STM32.sch]
2020-08-05 Added kicad design with 4 pressure sensors for daugthers PCB Added DigiKey number for power connector
    [BOM_keep_breathing_ctrl.csv, PSU.sch, power_stepper.sch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]
2020-08-05 new gerber files
    [keep_breathing_ctrl-B_Cu.gbr, keep_breathing_ctrl-B_Mask.gbr, keep_breathing_ctrl-B_Paste.gbr, keep_breathing_ctrl-B_SilkS.gbr, keep_breathing_ctrl-Edge_Cuts.gbr, keep_breathing_ctrl-F_Cu.gbr, keep_breathing_ctrl-F_Mask.gbr, keep_breathing_ctrl-F_Paste.gbr]
2020-08-05 Added mouse bites for pressure sensors PCB
    [pressure_sensors.kicad_pcb]
2020-08-05 created new gerber files
    [pressure_sensors-B_Cu.gbr, pressure_sensors-B_Mask.gbr, pressure_sensors-B_SilkS.gbr, pressure_sensors-Edge_Cuts.gbr, pressure_sensors-F_Cu.gbr, pressure_sensors-F_Mask.gbr, pressure_sensors-F_SilkS.gbr, pressure_sensors-NPTH.drl]
2020-12-04 Added and example to read all Analog signals in S0 to S8 connectors
2021-01-10 Added blinky and Uart example with Zephyr RTOS
2021-09-16 Nueva version para ventilador electroneumatico
    [BOM_keep_breathing_ctrl.csv, ESP32.sch, ElectroValves.sch, FPGA_ICE40UP5K.sch, I2C.sch, PSU.sch, Rapsberry.sch, STM32.sch]
2021-09-30 driver for motor eliminated
    [ElectroValves.sch, keep_breathing_ctrl.kicad_pcb, power_stepper.sch]
2021-11-05 Position for J2 U1 and U2 modified
    [ABPDANT015PGAA5_sensor_module.kicad_pcb, ABPDANT015PGAA5_sensor_module.sch, test_1.sch]
2021-11-05 Modified J2 position
    [ABPDANT060MGAA5_sensor_module.kicad_pcb]
2021-11-05 J2 connector modified
    [ABPDJJT001PDSA3_sensor_module.kicad_pcb]
2022-02-02 Modified sensor modules and created module for 403-SFM3020 sensor
    [403SFM3020_sensor_module-B_Cu.gbr, 403SFM3020_sensor_module-B_Mask.gbr, 403SFM3020_sensor_module-B_Paste.gbr, 403SFM3020_sensor_module-B_SilkS.gbr, 403SFM3020_sensor_module-Edge_Cuts.gbr, 403SFM3020_sensor_module-F_Cu.gbr, 403SFM3020_sensor_module-F_Mask.gbr, 403SFM3020_sensor_module-F_Paste.gbr]
2022-05-26 PCB for oxygen sensor
    [.sensor_oxigeno.kicad_pcb, sensor_oxigeno.kicad_pcb, sensor_oxigeno.sch]
2022-05-27 Gerber files created
    [403SFM3020_sensor_module-B_Cu.gbr, 403SFM3020_sensor_module-B_Mask.gbr, 403SFM3020_sensor_module-B_SilkS.gbr, 403SFM3020_sensor_module-Edge_Cuts.gbr, 403SFM3020_sensor_module-F_Cu.gbr, 403SFM3020_sensor_module-F_Mask.gbr, 403SFM3020_sensor_module-F_SilkS.gbr, 403SFM3020_sensor_module-NPTH-drl_map.gbr]
2023-04-05 BOM updated and 3D shape for bornier added
    [BOM_ABPDANT060MGAA5_sensor_module.csv, BOM_sensor_oxigeno.csv, User Library-bornera-1.STEP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]
